dabonetn/Apple2Card-Dan-CR-Board-/PCB Front.jpg

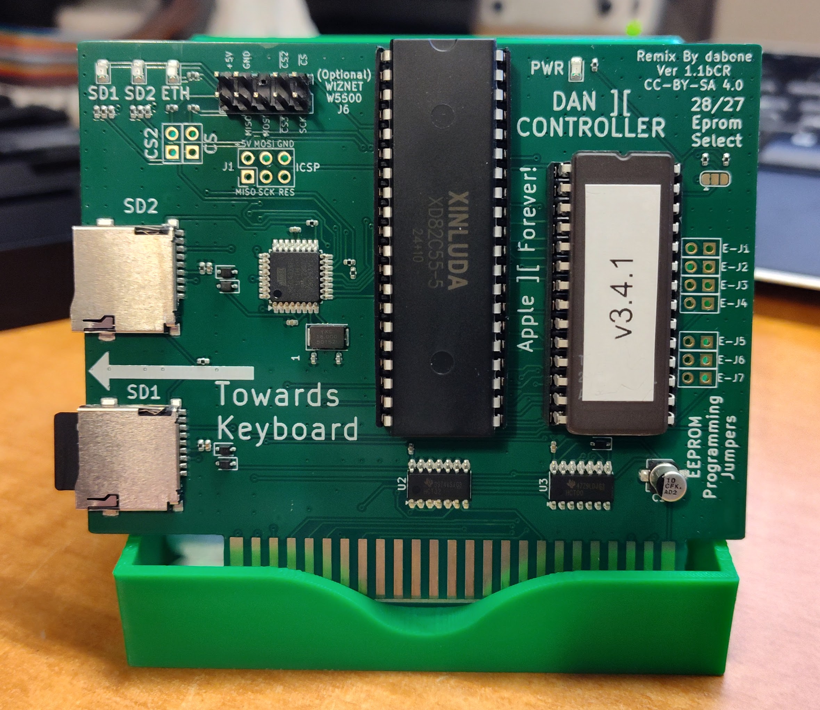
PCB Front.jpg
