dabonetn/Apple2Card-Dan-CR-Board-/Schematics.jpg

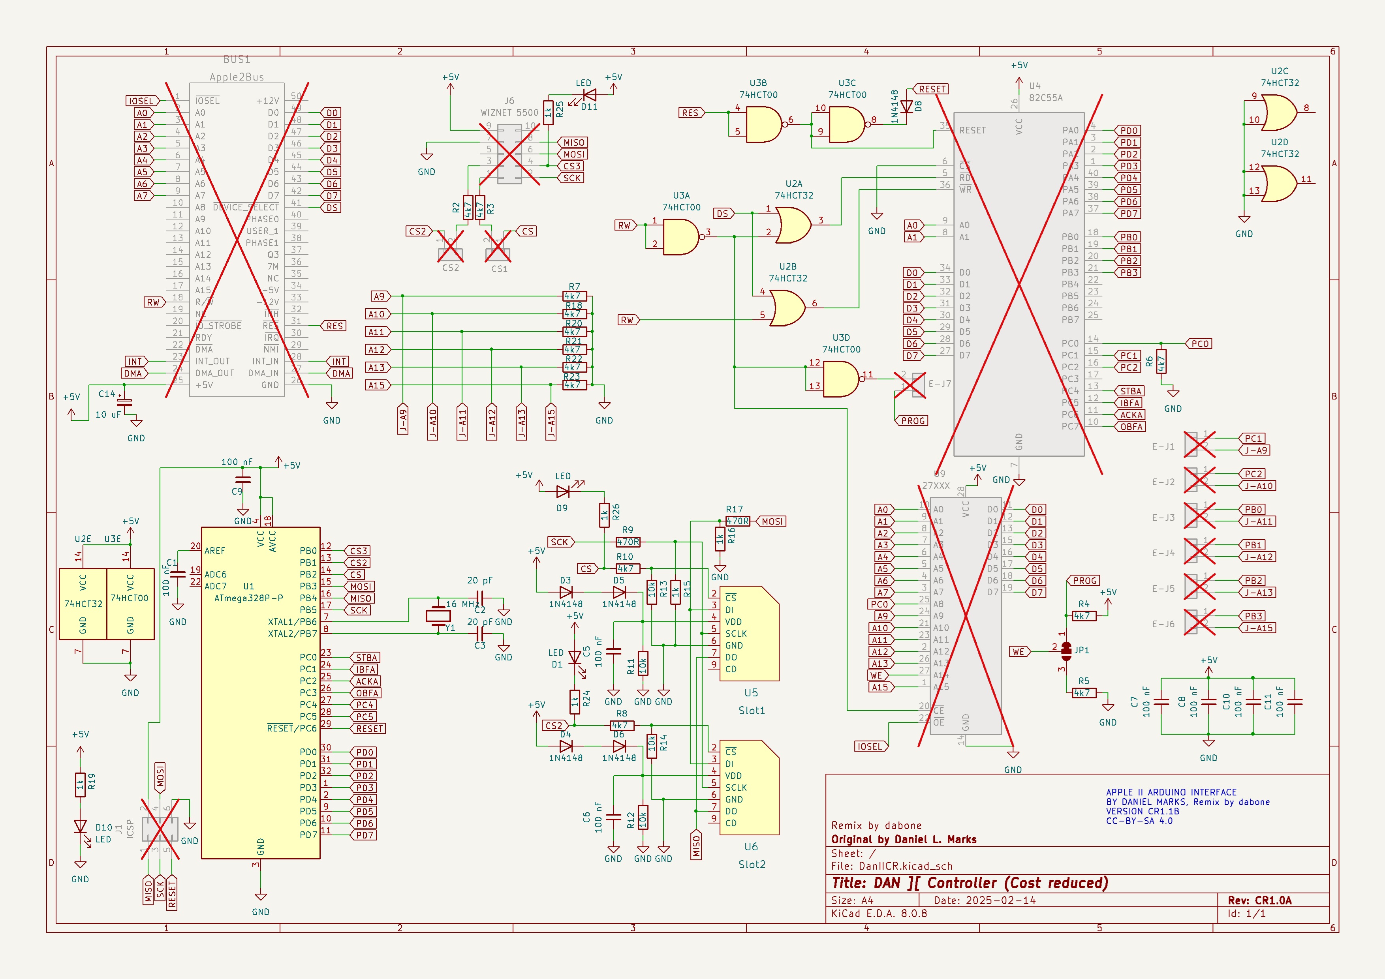
Schematics.jpg
