dabonetn/Apple2Card-Dan-CR-Board-/CAD/Apple IIe Ethernet Bracket Remix -M3.stl

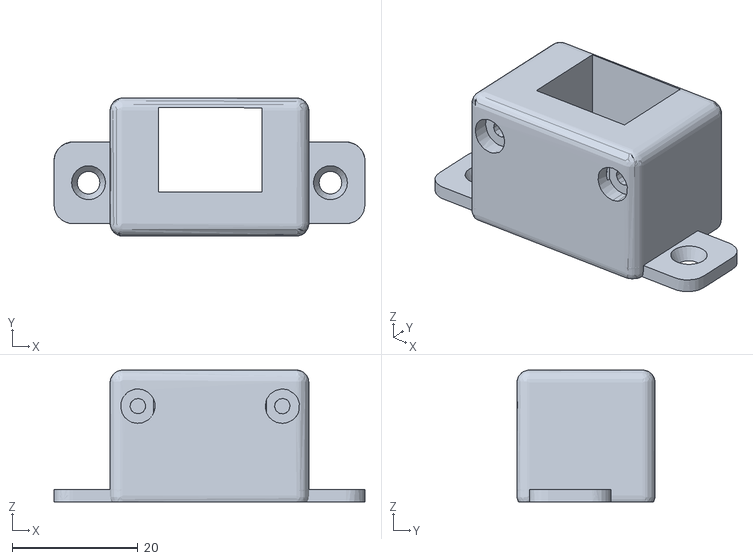
[picture p13: CAD file, 2025-04-05]
CAD/Apple IIe Ethernet Bracket Remix -M3.stl
49.5 x 22.0 x 21.0
