dabonetn/Apple2Card-Dan-CR-Board-/OriginalFiles/CAD/EthernetCover.FCStd

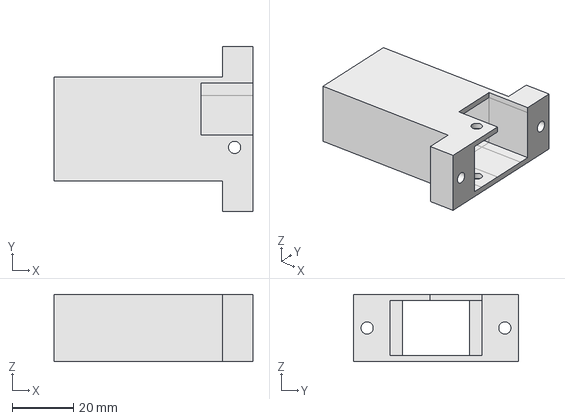
[picture p14: CAD file, 2025-02-25]
OriginalFiles/CAD/EthernetCover.FCStd
65.0 x 54.0 x 22.0 mm
