dabonetn/Apple2Card-Dan-CR-Board-/CAD/Apple IIe Ethernet Bracket Remix -M3 -Internal Bracket.stl

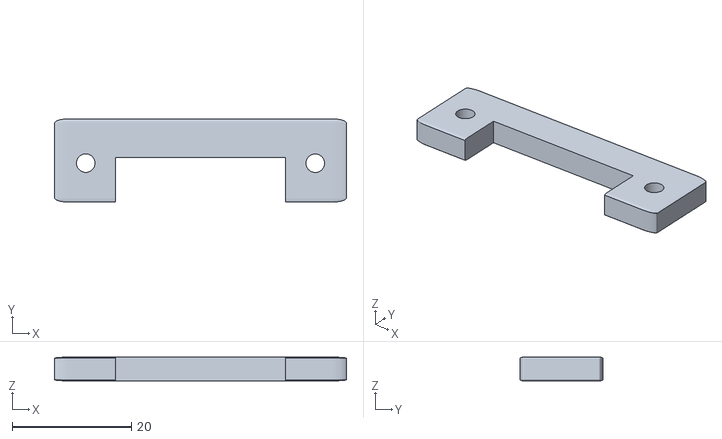
[picture p15: CAD file, 2025-04-05]
CAD/Apple IIe Ethernet Bracket Remix -M3 -Internal Bracket.stl
49.0 x 14.0 x 4.00
