dabonetn/Apple2Card-Dan-CR-Board-/OriginalFiles/CAD/Apple_IIe_EthernetMount_DB19.stl

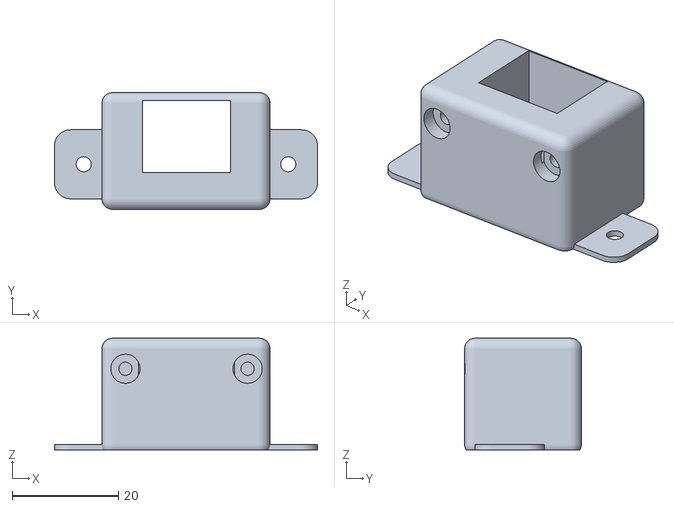
[picture p16: CAD file, 2023-09-25]
OriginalFiles/CAD/Apple_IIe_EthernetMount_DB19.stl
49.5 x 22.0 x 21.0
