dabonetn/Apple2Card-Dan-CR-Board-/OriginalFiles/CAD/AppleIII_Wiznet_Slot_Bracket.stl

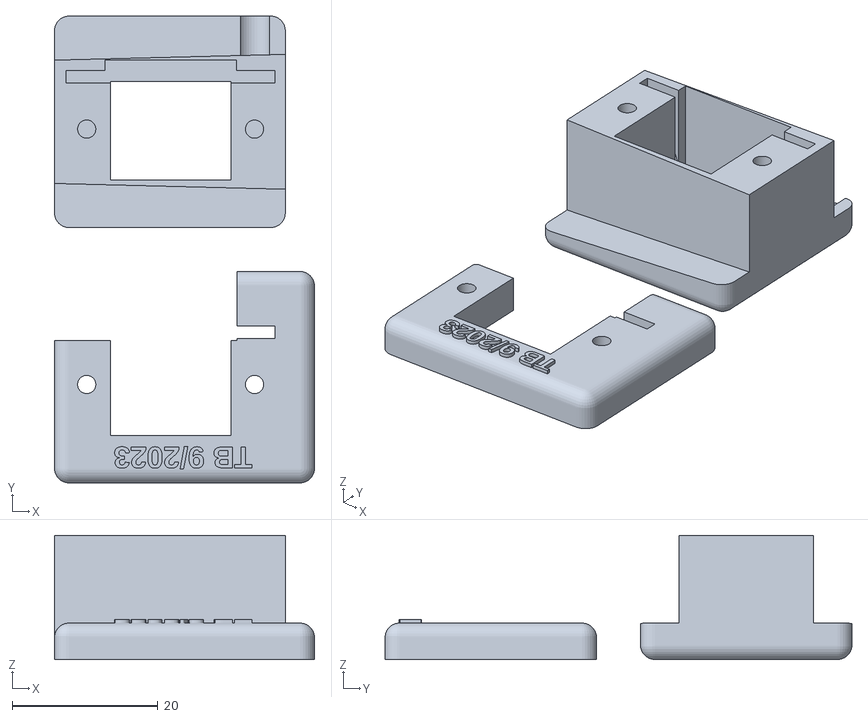
[picture p17: CAD file, 2023-09-20]
OriginalFiles/CAD/AppleIII_Wiznet_Slot_Bracket.stl
35.7 x 64.0 x 17.0
