dabonetn/Apple2Card-Dan-CR-Board-/(list of files, cad)

Other CAD files:
OriginalFiles/CAD/EthernetCover-EthernetMount.stl
