dabonetn/Apple2Card-Dan-CR-Board-/OriginalFiles/Apple2Card/Apple2Card-schematic.pdf

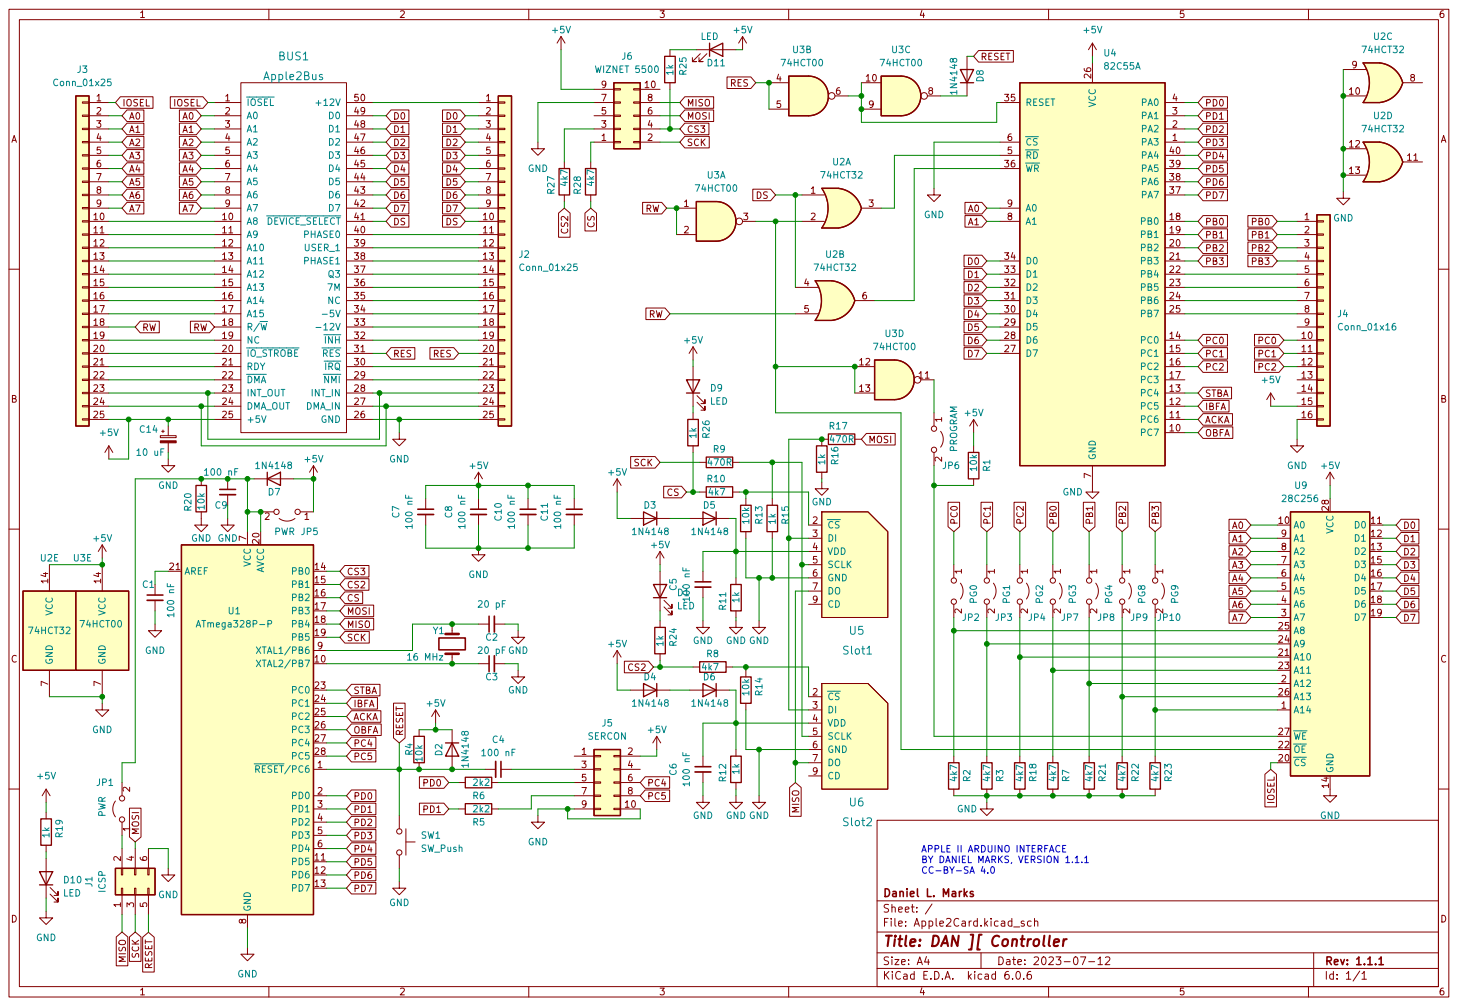
[picture p18: page 1]

13 | 13
14 | 14

APPLE II ARDUINO INTERFACE
BY DANIEL MARKS, VERSION 1.1.1 CC-BY-SA 4.0

File: Apple2Card.kicad_sch Sheet: / Daniel L. Marks

Id: 1/1 Title: DAN ][ Controller
