dabonetn/Apple2Card-Dan-CR-Board-/OriginalFiles/Apple2Card_x44/Apple2Card-schematic.pdf

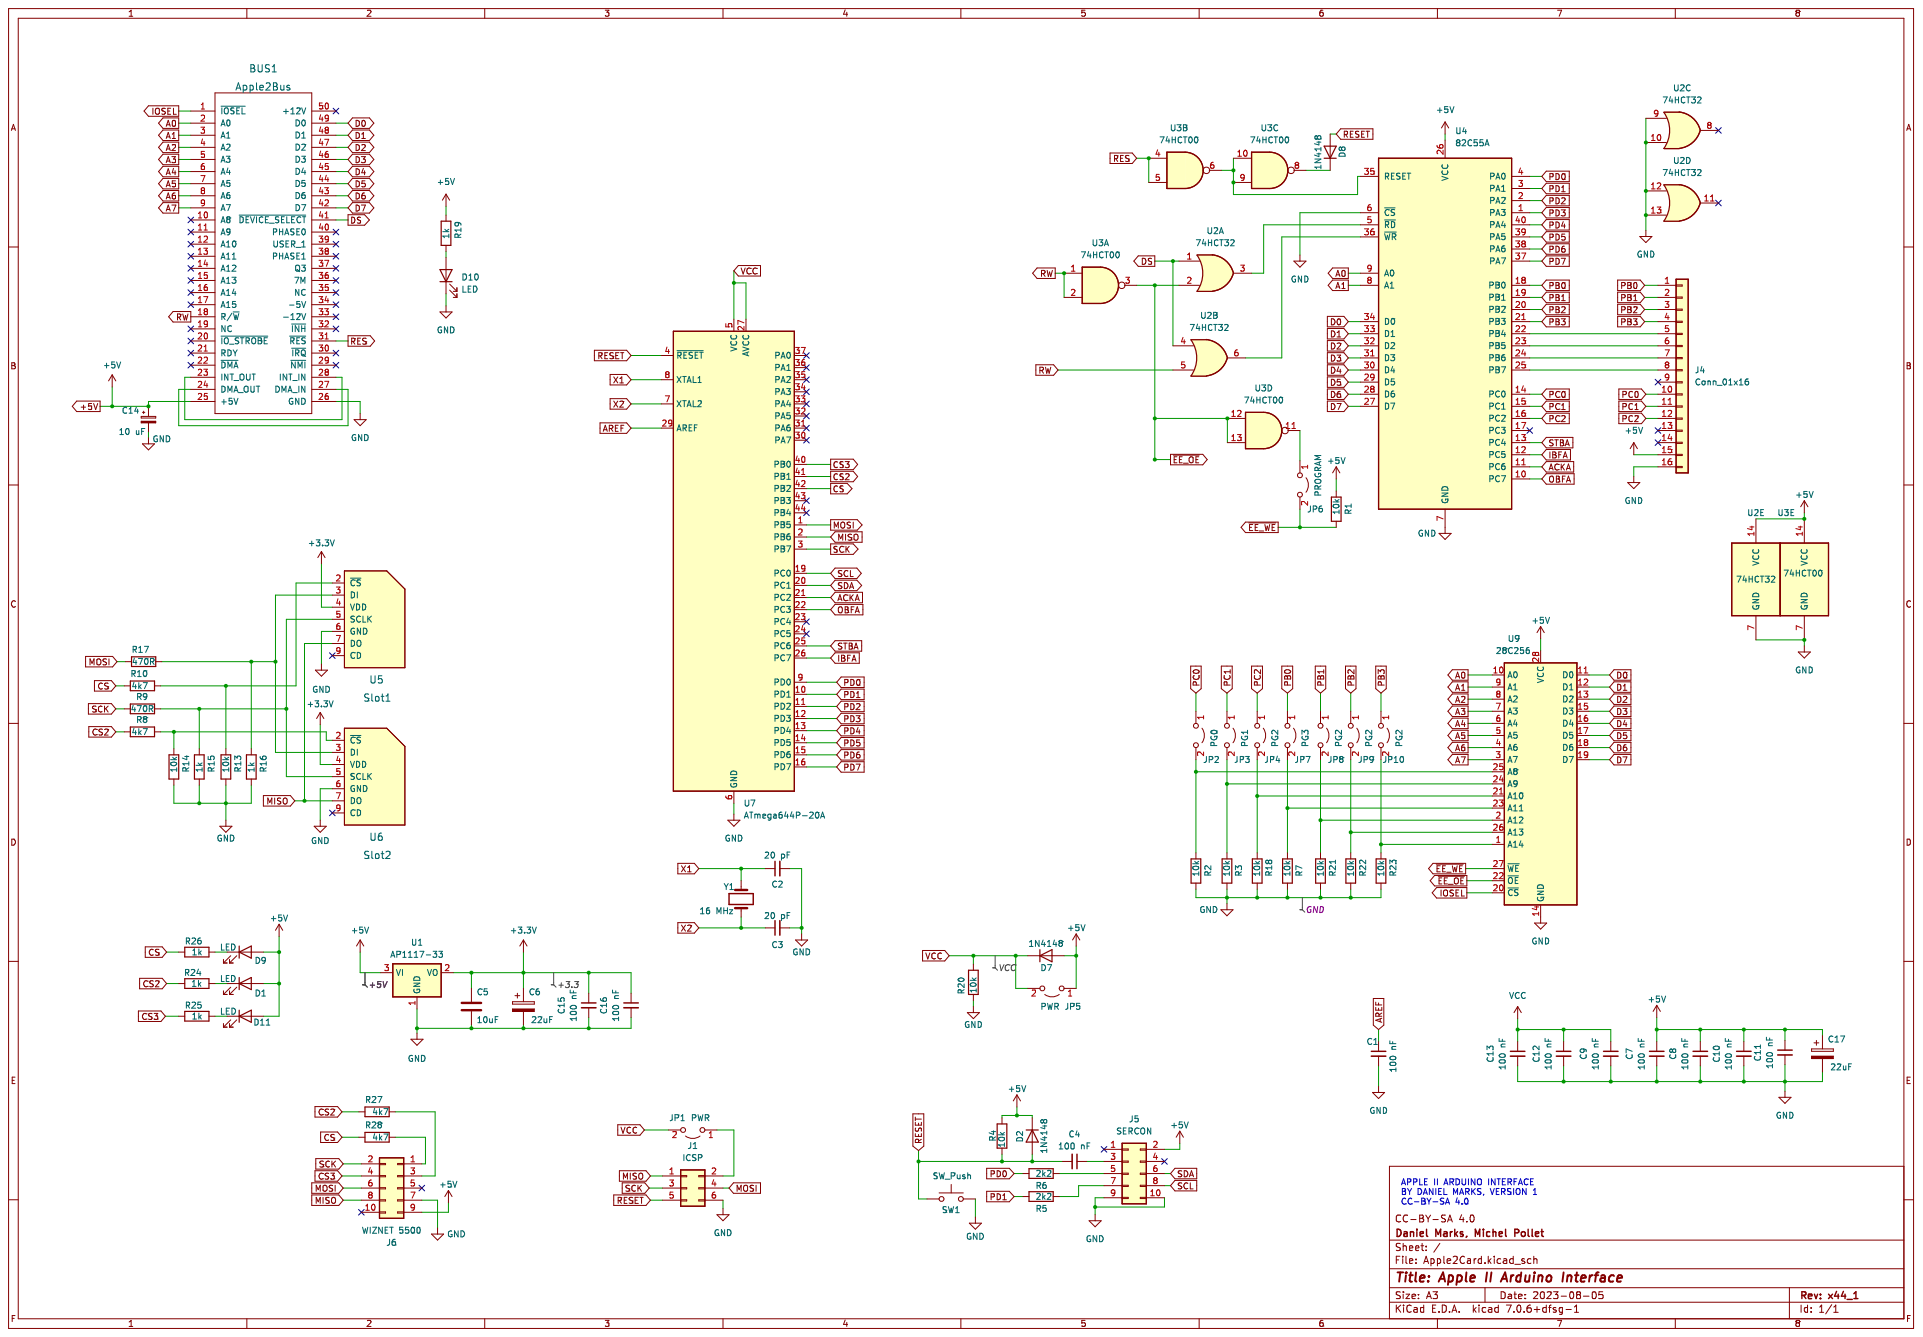
[picture p19: page 1]
