dabonetn/Apple2Card-Dan-CR-Board-/OriginalFiles/Apple2Card_x44/Apple2Card.kicad_pcb

## KiCad design OriginalFiles/Apple2Card_x44/Apple2Card.kicad_pcb (2023-08-09)

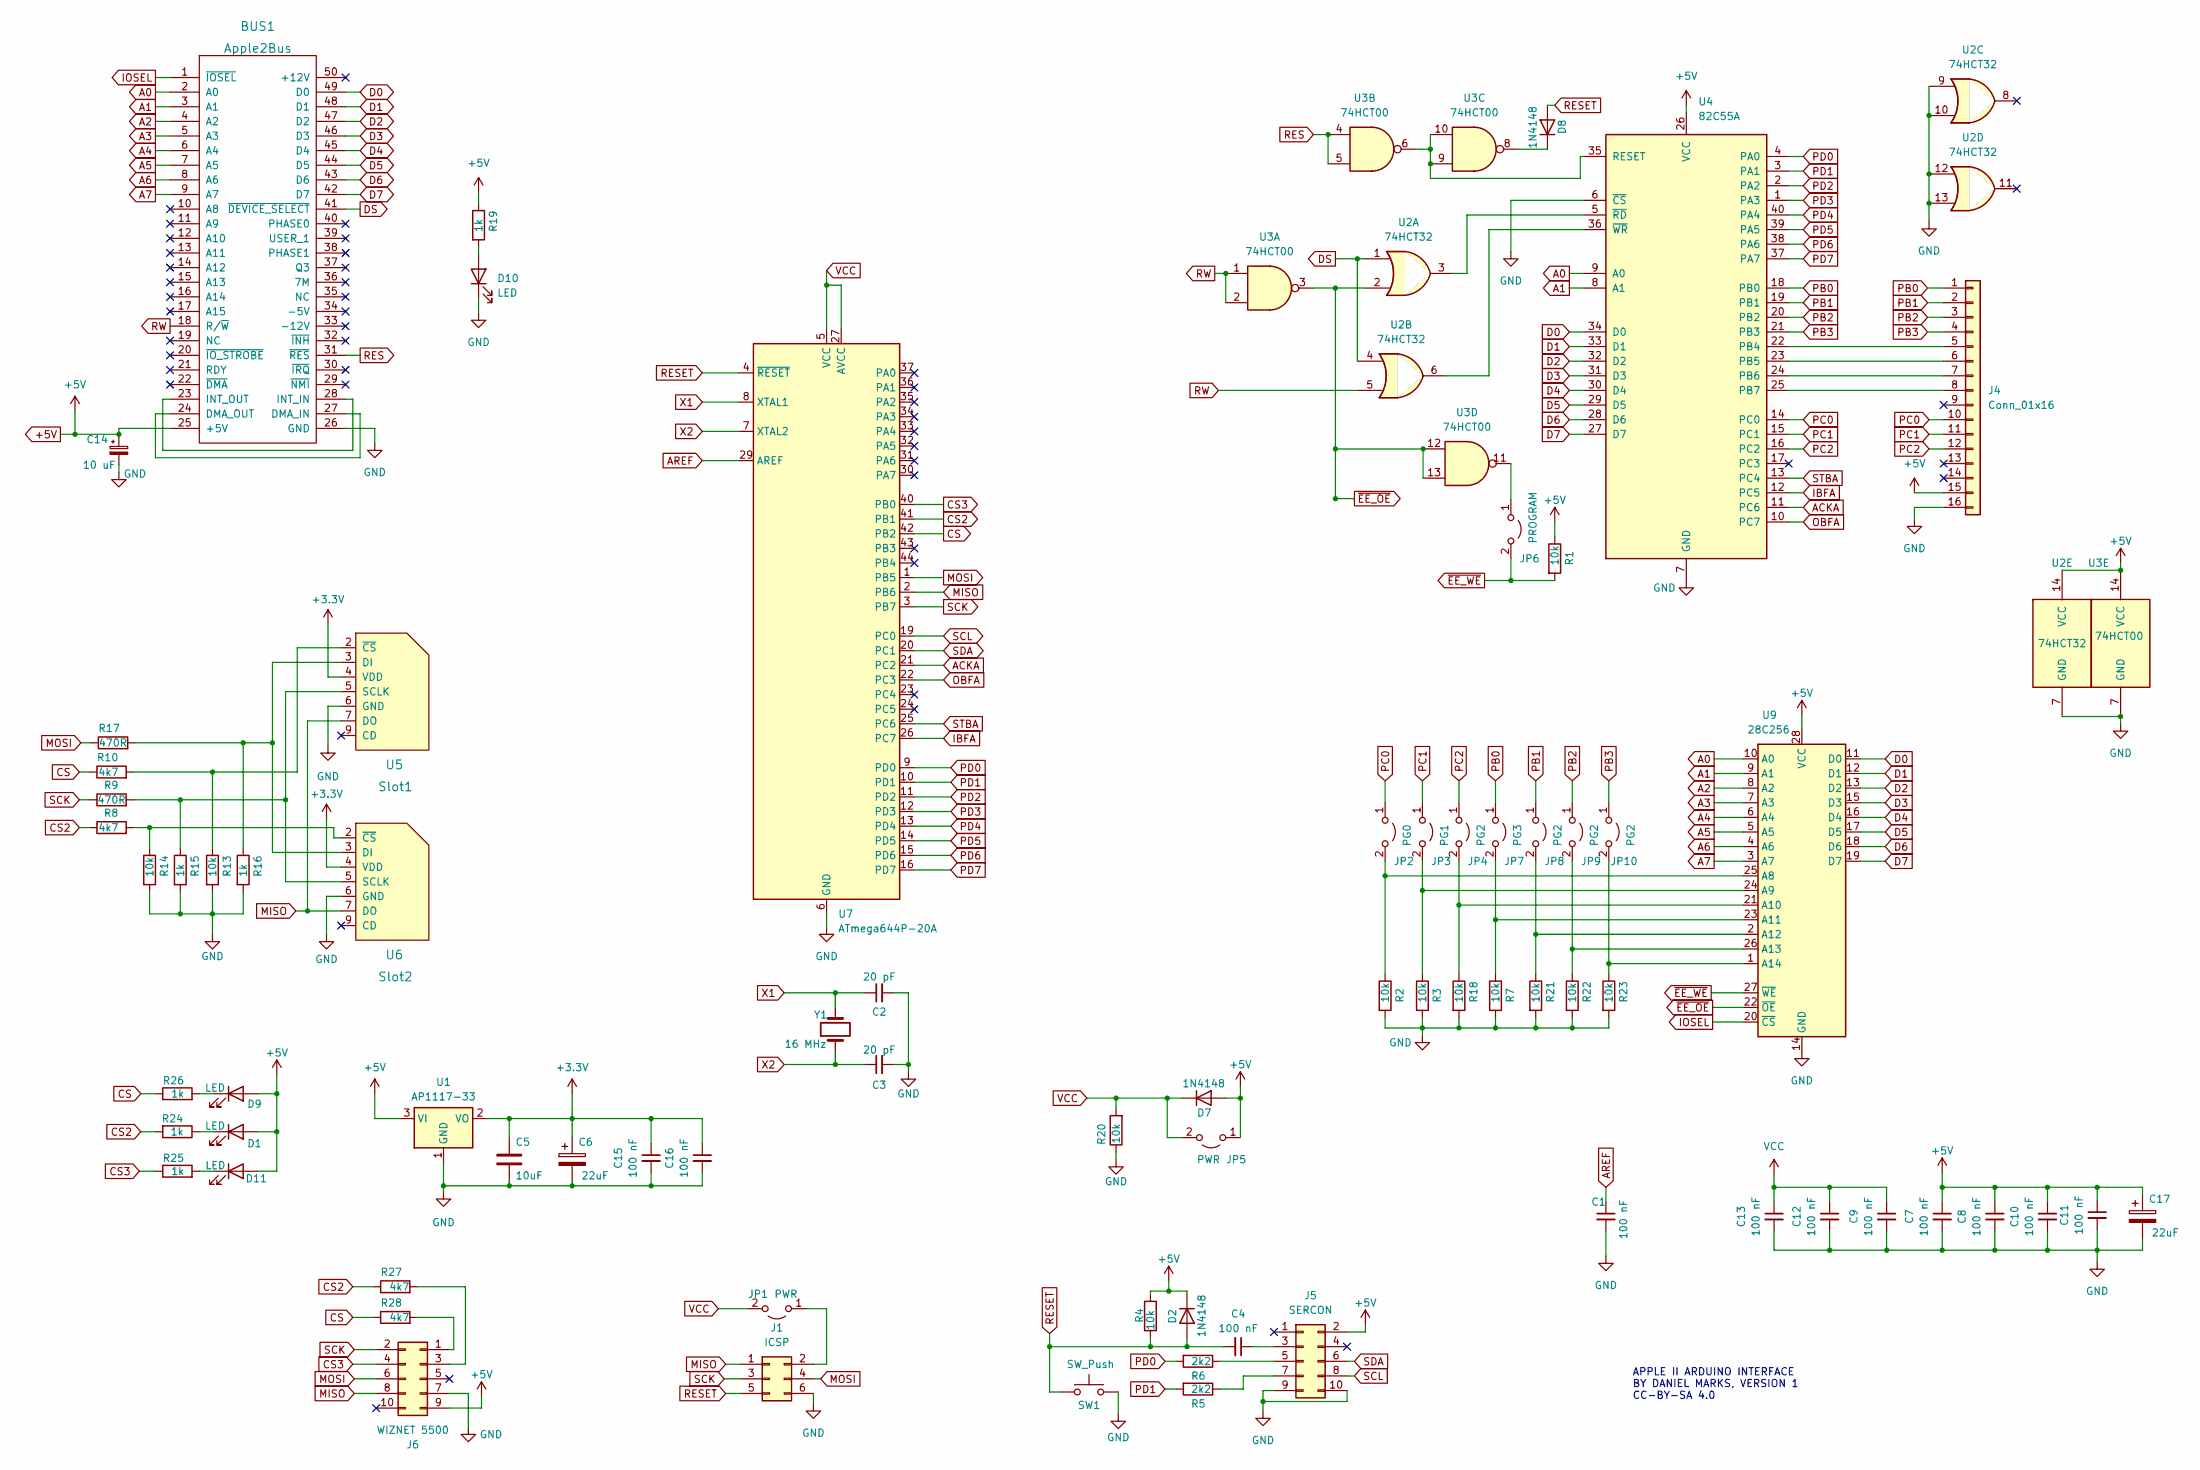
[picture p20: schematic Apple2Card.kicad_sch, Apple II Arduino Interface]

Parts:
BUS1: Apple2Bus; Apple2Slot
C1, C4, C7, C8, C9, C10, C11, C12, C13, C15, C16: 100 nF; C_0603_1608Metric_Pad1.08x0.95mm_HandSolder; LCSC C14663
C2, C3: 20 pF; C_0603_1608Metric_Pad1.08x0.95mm_HandSolder; LCSC C1620
C5: 10uF; C_0805_2012Metric_Pad1.18x1.45mm_HandSolder; LCSC C28323
C6, C17: 22uF; CP_EIA-6032-20_AVX-F_Pad2.25x2.35mm_HandSolder; LCSC C130377
C14: 10 uF; C_0805_2012Metric_Pad1.18x1.45mm_HandSolder; LCSC C1779
D1, D9, D11: LED; LED_0805_2012Metric_Pad1.15x1.40mm_HandSolder; LCSC C84256
D2, D7, D8: 1N4148; D_SOD-323_HandSoldering; LCSC C2128
D10: LED; LED_0805_2012Metric_Pad1.15x1.40mm_HandSolder; LCSC C434435
J1: ICSP; PinHeader_2x03_P2.54mm_Vertical; LCSC C492441
J4: Conn_01x16; PinHeader_1x16_P2.54mm_Vertical
J5: SERCON; PinHeader_2x05_P2.54mm_Vertical; LCSC C429962
J6: WIZNET 5500; PinHeader_2x05_P2.54mm_Vertical; LCSC C429962
JP1, JP5: PWR; PinHeader_1x02_P2.54mm_Vertical; LCSC C234182
JP2: PG0; PinHeader_1x02_P2.54mm_Vertical; LCSC C234182
JP3: PG1; PinHeader_1x02_P2.54mm_Vertical; LCSC C234182
JP4, JP8, JP9, JP10: PG2; PinHeader_1x02_P2.54mm_Vertical; LCSC C234182
JP6: PROGRAM; PinHeader_1x02_P2.54mm_Vertical; LCSC C234182
JP7: PG3; PinHeader_1x02_P2.54mm_Vertical; LCSC C234182
R1, R2, R3, R4, R7, R13, R14, R18, R20, R21, R22, R23: 10k; R_0603_1608Metric_Pad0.98x0.95mm_HandSolder; LCSC C25804
R5, R6: 2k2; R_0603_1608Metric_Pad0.98x0.95mm_HandSolder; LCSC C114662
R8, R10, R27, R28: 4k7; R_0603_1608Metric_Pad0.98x0.95mm_HandSolder; LCSC C105428
R9, R17: 470R; R_0603_1608Metric_Pad0.98x0.95mm_HandSolder; LCSC C114669
R15, R16, R19, R24, R25, R26: 1k; R_0603_1608Metric_Pad0.98x0.95mm_HandSolder; LCSC C21190
SW1: SW_Push; SW_Push_1P1T_NO_6x6mm_H9.5mm; LCSC C221869
U1: AP1117-33; SOT-223-3_TabPin2; LCSC C347222
U2: 74HCT32; SOIC-14_3.9x8.7mm_P1.27mm; LCSC C6781
U3: 74HCT00; SOIC-14_3.9x8.7mm_P1.27mm; LCSC C6764
U4: 82C55A; DIP-40_W15.24mm_Socket; LCSC C707086
U5: Slot1; GCT-MEM2055-00-190-01-A; LCSC C5155564
U6: Slot2; GCT-MEM2055-00-190-01-A; LCSC C5155564
U7: ATmega644P-20A; TQFP-44_10x10mm_P0.8mm
U9: 28C256; DIP-28_W15.24mm_Socket; LCSC C2874016
Y1: 16 MHz; Crystal_SMD_3225-4Pin_3.2x2.5mm_HandSoldering; LCSC C13738

Connections:
+3.3V: C5.1, C6.1, C15.1, C16.1, U1.2 (VO), U5.4 (VDD), U6.4 (VDD)
+5V: BUS1.25 (+5V), C7.1, C8.1, C10.1, C11.1, C14.1, C17.1, D1.2 (A), D2.1 (K), D7.2 (A), D9.2 (A), D11.2 (A), J4.15, J5.2, J6.9, JP5.1 (A), R1.1, R4.1, R19.1, U1.3 (VI), U2.14 (VCC), U3.14 (VCC), U4.26 (VCC), U9.28 (VCC)
A0: BUS1.2 (A0), U4.9 (A0), U9.10 (A0)
A1: BUS1.3 (A1), U4.8 (A1), U9.9 (A1)
A2: BUS1.4 (A2), U9.8 (A2)
A3: BUS1.5 (A3), U9.7 (A3)
A4: BUS1.6 (A4), U9.6 (A4)
A5: BUS1.7 (A5), U9.5 (A5)
A6: BUS1.8 (A6), U9.4 (A6)
A7: BUS1.9 (A7), U9.3 (A7)
ACKA: U4.11 (PC6), U7.21 (PC2)
AREF: C1.1, U7.29 (AREF)
CS: R10.1, R26.1, R28.1, U7.42 (PB2)
CS2: R8.1, R24.2, R27.1, U7.41 (PB1)
CS3: J6.4, R25.1, U7.40 (PB0)
D0: BUS1.49 (D0), U4.34 (D0), U9.11 (D0)
D1: BUS1.48 (D1), U4.33 (D1), U9.12 (D1)
D2: BUS1.47 (D2), U4.32 (D2), U9.13 (D2)
D3: BUS1.46 (D3), U4.31 (D3), U9.15 (D3)
D4: BUS1.45 (D4), U4.30 (D4), U9.16 (D4)
D5: BUS1.44 (D5), U4.29 (D5), U9.17 (D5)
D6: BUS1.43 (D6), U4.28 (D6), U9.18 (D6)
D7: BUS1.42 (D7), U4.27 (D7), U9.19 (D7)
DS: BUS1.41 (~DEVICE_SELECT), U2.1, U2.4
GND: BUS1.26 (GND), C1.2, C2.2, C3.2, C5.2, C6.2, C7.2, C8.2, C9.2, C10.2, C11.2, C12.2, C13.2, C14.2, C15.2, C16.2, C17.2, D10.1 (K), J1.6, J4.16, J5.9, J5.10, J6.7, R2.2, R3.2, R7.2, R13.2, R14.2, R15.2, R16.2, R18.2, R20.1, R21.2, R22.2, R23.2, SW1.2, U1.1 (GND), U2.7 (GND), U2.9, U2.10, U2.12, U2.13, U3.7 (GND), U4.6 (~CS), U4.7 (GND), U5.6 (GND), U6.6 (GND), U7.6 (GND), U7.18 (GND), U7.28 (GND), U7.39 (GND), U9.14 (GND)
IBFA: U4.12 (PC5), U7.26 (PC7)
IOSEL: BUS1.1 (~IOSEL), U9.20 (~CS)
MISO: J1.1, J6.8, U5.7 (DO), U6.7 (DO), U7.2 (PB6)
MOSI: J1.4, J6.6, R17.1, U7.1 (PB5)
unnamed: BUS1.24 (DMA_OUT), BUS1.27 (DMA_IN)
unnamed: BUS1.23 (INT_OUT), BUS1.28 (INT_IN)
unnamed: D1.1 (K), R24.1
unnamed: D8.1 (K), U3.8
unnamed: D9.1 (K), R26.2
unnamed: D10.2 (A), R19.2
unnamed: D11.1 (K), R25.2
unnamed: J1.2, JP1.1 (A)
unnamed: J4.5, U4.22 (PB4)
unnamed: J4.6, U4.23 (PB5)
unnamed: J4.7, U4.24 (PB6)
unnamed: J4.8, U4.25 (PB7)
unnamed: C4.1, J5.3
unnamed: J5.5, R6.1
unnamed: J5.7, R5.1
unnamed: J6.1, R28.2
unnamed: J6.3, R27.2
unnamed: JP2.2 (B), R2.1, U9.25 (A8)
unnamed: JP3.2 (B), R3.1, U9.24 (A9)
unnamed: JP4.2 (B), R18.1, U9.21 (A10)
unnamed: JP6.1 (A), U3.11
unnamed: JP7.2 (B), R7.1, U9.23 (A11)
unnamed: JP8.2 (B), R21.1, U9.2 (A12)
unnamed: JP9.2 (B), R22.1, U9.26 (A13)
unnamed: JP10.2 (B), R23.1, U9.1 (A14)
unnamed: U3.6, U3.9, U3.10, U4.35 (RESET)
unnamed: U2.3, U4.5 (~RD)
unnamed: U2.6, U4.36 (~WR)
unnamed: R16.1, R17.2, U5.3 (DI), U6.3 (DI)
unnamed: R9.2, R15.1, U5.5 (SCLK), U6.5 (SCLK)
unnamed: R10.2, R13.1, U5.2 (~CS)
unnamed: R8.2, R14.1, U6.2 (~CS)
OBFA: U4.10 (PC7), U7.22 (PC3)
PB0: J4.1, JP7.1 (A), U4.18 (PB0)
PB1: J4.2, JP8.1 (A), U4.19 (PB1)
PB2: J4.3, JP9.1 (A), U4.20 (PB2)
PB3: J4.4, JP10.1 (A), U4.21 (PB3)
PC0: J4.10, JP2.1 (A), U4.14 (PC0)
PC1: J4.11, JP3.1 (A), U4.15 (PC1)
PC2: J4.12, JP4.1 (A), U4.16 (PC2)
PD0: R6.2, U4.4 (PA0), U7.9 (PD0)
PD1: R5.2, U4.3 (PA1), U7.10 (PD1)
PD2: U4.2 (PA2), U7.11 (PD2)
PD3: U4.1 (PA3), U7.12 (PD3)
PD4: U4.40 (PA4), U7.13 (PD4)
PD5: U4.39 (PA5), U7.14 (PD5)
PD6: U4.38 (PA6), U7.15 (PD6)
PD7: U4.37 (PA7), U7.16 (PD7)
RES: BUS1.31 (~RES), U3.4, U3.5
RESET: C4.2, D2.2 (A), D8.2 (A), J1.5, R4.2, SW1.1, U7.4 (~RESET)
RW: BUS1.18 (R/~W), U2.5, U3.1, U3.2
SCK: J1.3, J6.2, R9.1, U7.3 (PB7)
SCL: J5.8, U7.19 (PC0)
SDA: J5.6, U7.20 (PC1)
STBA: U4.13 (PC4), U7.25 (PC6)
VCC: C9.1, C12.1, C13.1, D7.1 (K), JP1.2 (B), JP5.2 (B), R20.2, U7.5 (VCC), U7.17 (VCC), U7.27 (AVCC), U7.38 (VCC)
X1: C2.1, U7.8 (XTAL1), Y1.2
X2: C3.1, U7.7 (XTAL2), Y1.1
~EE_OE: U2.2, U3.3, U3.12, U3.13, U9.22 (~OE)
~EE_WE: JP6.2 (B), R1.2, U9.27 (~WE)

Notes on the sheet:
APPLE II ARDUINO INTERFACE BY DANIEL MARKS, VERSION 1 CC-BY-SA 4.0

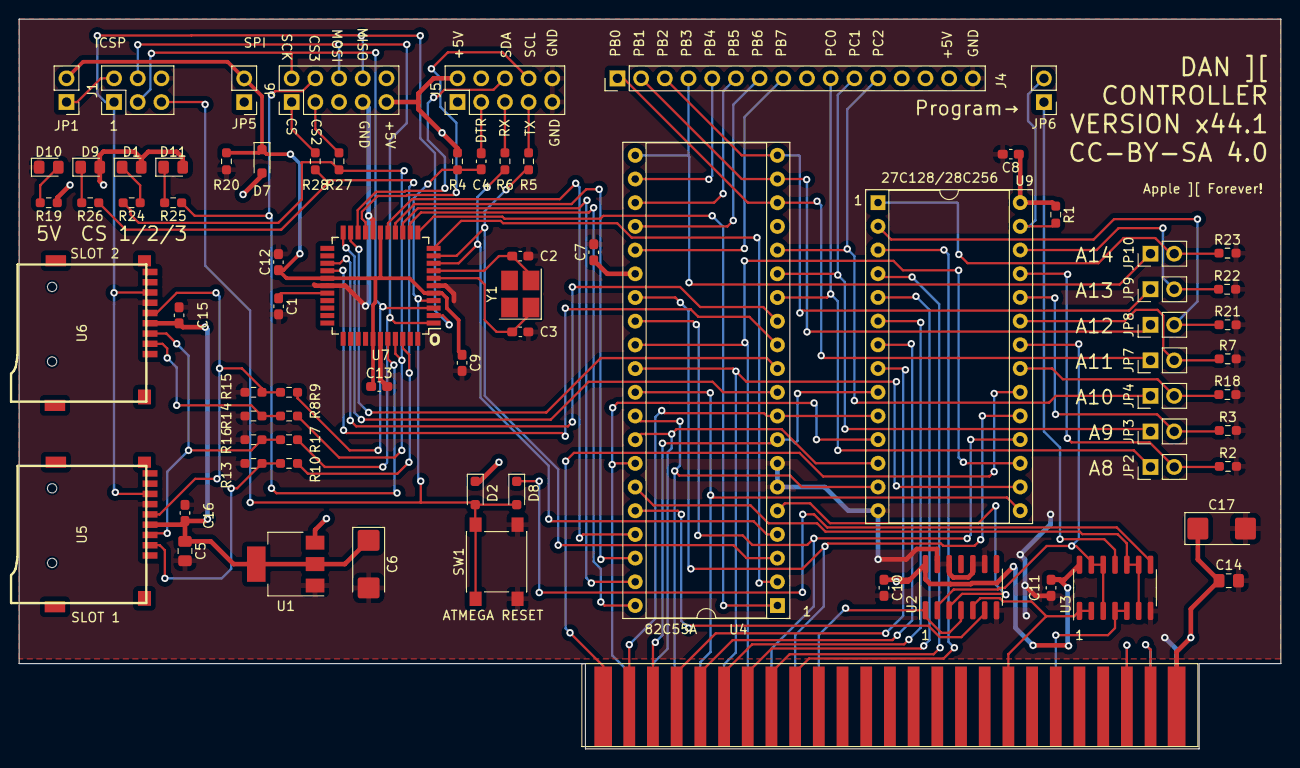
[picture p21: board Apple2Card.kicad_pcb from above]

Board: 2 copper layers, 135.3 x 78.2 mm, 75 parts (0 on the bottom side), 89 nets.
