dabonetn/Apple2Card-Dan-CR-Board-/Kicad/DanIICR.kicad_sch

## KiCad design Kicad/DanIICR.kicad_sch (2025-04-05)

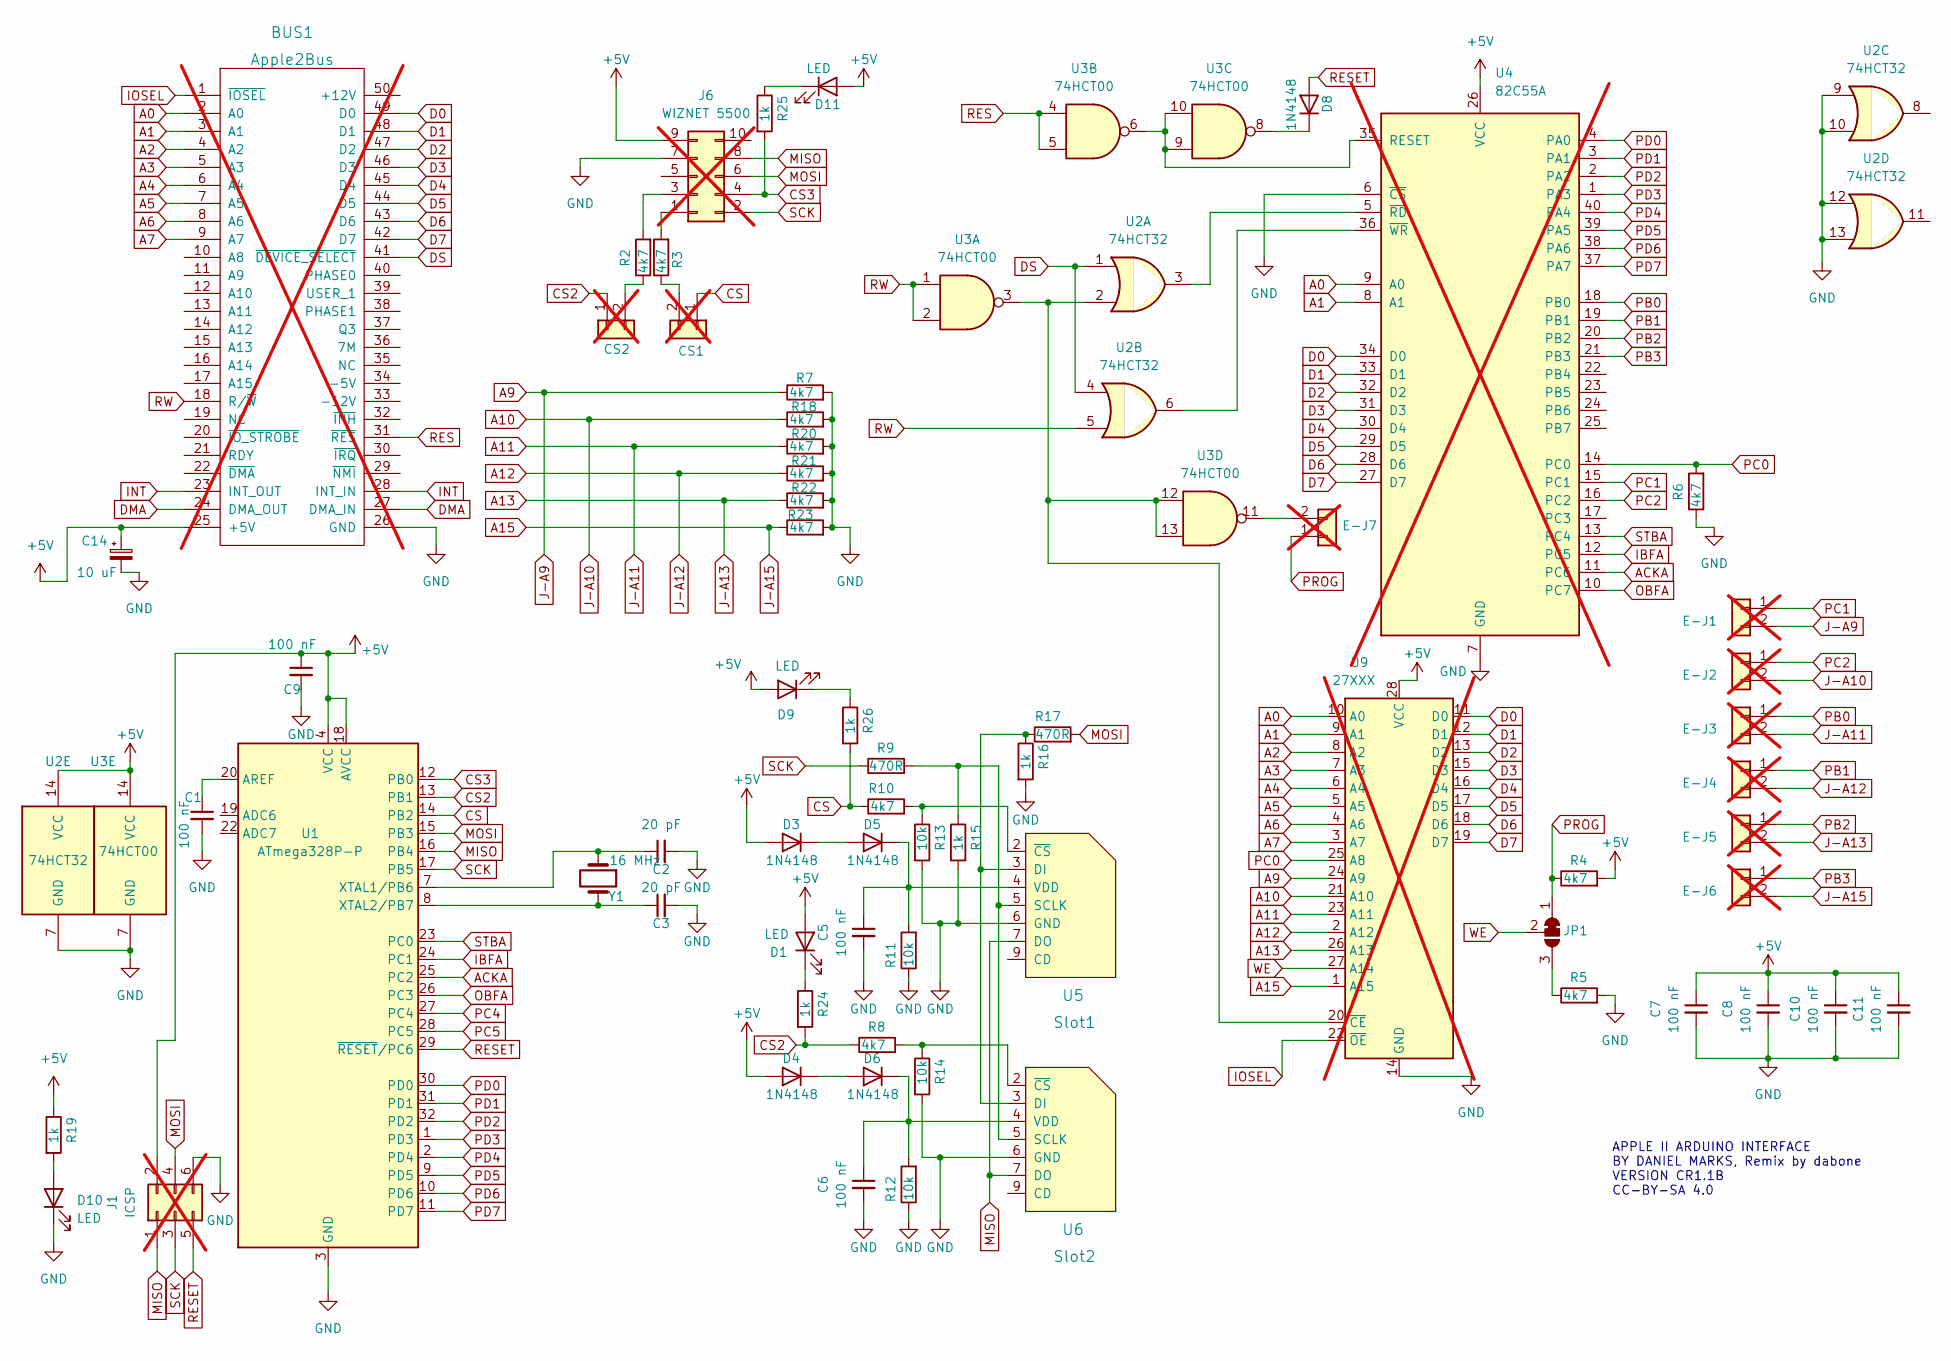
[picture p22: schematic DanIICR.kicad_sch]

Parts:
BUS1: Apple2Bus; Apple2Slot; not fitted
C1, C5, C6, C7, C8, C9, C10, C11: 100 nF; C_0402_1005Metric
C2, C3: 20 pF; C_0402_1005Metric
C14: 10 uF; CP_Elec_4x5.7
CS1, CS2: Jumper; PinHeader_1x02_P2.54mm_Vertical; not fitted
D1, D9, D10, D11: LED; LED_0805_2012Metric
D3, D4, D5, D6, D8: 1N4148; D_SOD-323
E-J1, E-J2, E-J3, E-J4, E-J5, E-J6, E-J7: Jumper; PinHeader_1x02_P2.54mm_Vertical; not fitted
J1: ICSP; PinHeader_2x03_P2.54mm_Vertical; not fitted
J6: WIZNET 5500; PinHeader_2x05_P2.54mm_Vertical; not fitted
JP1: SolderJumper_3_Bridged12; SolderJumper-3_P1.3mm_Bridged2Bar12_RoundedPad1.0x1.5mm
R2, R3, R4, R5, R6, R7, R10, R18, R20, R21, R22, R23: 4k7; R_0402_1005Metric
R8: 4k7; R_0402_1005Metric; LCSC Part # C2906941
R9, R17: 470R; R_0402_1005Metric
R11, R12, R13, R14: 10k; R_0402_1005Metric
R15, R16, R19, R24, R25, R26: 1k; R_0402_1005Metric
U1: ATmega328P-P; TQFP-32_7x7mm_P0.8mm
U2: 74HCT32; SOIC-14_3.9x8.7mm_P1.27mm
U3: 74HCT00; SOIC-14_3.9x8.7mm_P1.27mm
U4: 82C55A; DIP-40_W15.24mm_Socket; not fitted
U5: Slot1; MicroSD_Card_TB; LCSC Part # C381084
U6: Slot2; MicroSD_Card_TB; LCSC Part # C381084
U9: 27XXX; DIP-28_W15.24mm; not fitted
Y1: 16 MHz; Crystal_SMD_5032-2Pin_5.0x3.2mm

Connections:
+5V: BUS1.25 (+5V), C7.1, C8.1, C9.1, C10.1, C11.1, C14.1, D1.2 (A), D3.2 (A), D4.2 (A), D9.2 (A), D11.2 (A), J1.2, J6.9, R4.2, R19.1, U1.4 (VCC), U1.6 (VCC), U1.18 (AVCC), U2.14 (VCC), U3.14 (VCC), U4.26 (VCC), U9.28 (VCC)
A0: BUS1.2 (A0), U4.9 (A0), U9.10 (A0)
A1: BUS1.3 (A1), U4.8 (A1), U9.9 (A1)
A2: BUS1.4 (A2), U9.8 (A2)
A3: BUS1.5 (A3), U9.7 (A3)
A4: BUS1.6 (A4), U9.6 (A4)
A5: BUS1.7 (A5), U9.5 (A5)
A6: BUS1.8 (A6), U9.4 (A6)
A7: BUS1.9 (A7), U9.3 (A7)
A9: E-J1.2, R7.1, U9.24 (A9)
A10: E-J2.2, R18.1, U9.21 (A10)
A11: E-J3.2, R20.1, U9.23 (A11)
A12: E-J4.2, R21.1, U9.2 (A12)
A13: E-J5.2, R22.1, U9.26 (A13)
A15: E-J6.2, R23.1, U9.1 (A15)
ACKA: U1.25 (PC2), U4.11 (PC6)
CS: CS1.1, R10.1, R26.2, U1.14 (PB2)
CS2: CS2.1, R8.1, R24.2, U1.13 (PB1)
CS3: J6.4, R25.2, U1.12 (PB0)
D0: BUS1.49 (D0), U4.34 (D0), U9.11 (D0)
D1: BUS1.48 (D1), U4.33 (D1), U9.12 (D1)
D2: BUS1.47 (D2), U4.32 (D2), U9.13 (D2)
D3: BUS1.46 (D3), U4.31 (D3), U9.15 (D3)
D4: BUS1.45 (D4), U4.30 (D4), U9.16 (D4)
D5: BUS1.44 (D5), U4.29 (D5), U9.17 (D5)
D6: BUS1.43 (D6), U4.28 (D6), U9.18 (D6)
D7: BUS1.42 (D7), U4.27 (D7), U9.19 (D7)
DMA: BUS1.24 (DMA_OUT), BUS1.27 (DMA_IN)
DS: BUS1.41 (~DEVICE_SELECT), U2.1, U2.4
GND: BUS1.26 (GND), C1.2, C2.2, C3.2, C5.2, C6.2, C7.2, C8.2, C9.2, C10.2, C11.2, C14.2, D10.1 (K), J1.6, J6.7, R5.2, R6.1, R7.2, R11.1, R12.1, R13.2, R14.2, R15.2, R16.2, R18.2, R20.2, R21.2, R22.2, R23.2, U1.3 (GND), U1.5 (GND), U1.21 (GND), U2.7 (GND), U2.9, U2.10, U2.12, U2.13, U3.7 (GND), U4.6 (~CS), U4.7 (GND), U5.6 (GND), U6.6 (GND), U9.14 (GND)
IBFA: U1.24 (PC1), U4.12 (PC5)
INT: BUS1.23 (INT_OUT), BUS1.28 (INT_IN)
IOSEL: BUS1.1 (~IOSEL), U9.22 (~OE)
MISO: J1.1, J6.8, U1.16 (PB4), U5.7 (DO), U6.7 (DO)
MOSI: J1.4, J6.6, R17.2, U1.15 (PB3)
unnamed: C1.1, U1.20 (AREF)
unnamed: C2.1, U1.7 (XTAL1/PB6), Y1.1
unnamed: C3.1, U1.8 (XTAL2/PB7), Y1.2
unnamed: C5.1, D5.1 (K), R11.2, U5.4 (VDD)
unnamed: C6.1, D6.1 (K), R12.2, U6.4 (VDD)
unnamed: CS1.2, R3.1
unnamed: CS2.2, R2.1
unnamed: D1.1 (K), R24.1
unnamed: D3.1 (K), D5.2 (A)
unnamed: D4.1 (K), D6.2 (A)
unnamed: D8.1 (K), U3.8
unnamed: D9.1 (K), R26.1
unnamed: D10.2 (A), R19.2
unnamed: D11.1 (K), R25.1
unnamed: E-J7.2, U3.11
unnamed: J6.1, R3.2
unnamed: J6.3, R2.2
unnamed: JP1.3 (B), R5.1
unnamed: R10.2, R13.1, U5.2 (~CS)
unnamed: R8.2, R14.1, U6.2 (~CS)
unnamed: R9.2, R15.1, U5.5 (SCLK), U6.5 (SCLK)
unnamed: R16.1, R17.1, U5.3 (DI), U6.3 (DI)
unnamed: U2.2, U3.3, U3.12, U3.13, U9.20 (~CE)
unnamed: U2.3, U4.5 (~RD)
unnamed: U2.6, U4.36 (~WR)
unnamed: U3.6, U3.9, U3.10, U4.35 (RESET)
OBFA: U1.26 (PC3), U4.10 (PC7)
PB0: E-J3.1, U4.18 (PB0)
PB1: E-J4.1, U4.19 (PB1)
PB2: E-J5.1, U4.20 (PB2)
PB3: E-J6.1, U4.21 (PB3)
PC0: R6.2, U4.14 (PC0), U9.25 (A8)
PC1: E-J1.1, U4.15 (PC1)
PC2: E-J2.1, U4.16 (PC2)
PC4: U1.27 (PC4)
PC5: U1.28 (PC5)
PD0: U1.30 (PD0), U4.4 (PA0)
PD1: U1.31 (PD1), U4.3 (PA1)
PD2: U1.32 (PD2), U4.2 (PA2)
PD3: U1.1 (PD3), U4.1 (PA3)
PD4: U1.2 (PD4), U4.40 (PA4)
PD5: U1.9 (PD5), U4.39 (PA5)
PD6: U1.10 (PD6), U4.38 (PA6)
PD7: U1.11 (PD7), U4.37 (PA7)
PROG: E-J7.1, JP1.1 (A), R4.1
RES: BUS1.31 (~RES), U3.4, U3.5
RESET: D8.2 (A), J1.5, U1.29 (~RESET/PC6)
RW: BUS1.18 (R/~W), U2.5, U3.1, U3.2
SCK: J1.3, J6.2, R9.1, U1.17 (PB5)
STBA: U1.23 (PC0), U4.13 (PC4)
WE: JP1.2 (C), U9.27 (A14)

Notes on the sheet:
APPLE II ARDUINO INTERFACE BY DANIEL MARKS, Remix by dabone VERSION CR1.1B CC-BY-SA 4.0
