dabonetn/Apple2Card-Dan-CR-Board-/OriginalFiles/Apple2Arduino/mmc_avr_spi.c

/*-----------------------------------------------------------------------*/
/* MMCv3/SDv1/SDv2 Controls via AVR SPI module                           */
/*-----------------------------------------------------------------------*/
/*
/  Copyright (C) 2016, ChaN, all right reserved.
/
/ * This software is a free software and there is NO WARRANTY.
/ * No restriction on use. You can use, modify and redistribute it for
/   any purpose as you like UNDER YOUR RESPONSIBILITY.
/ * Redistributions of source code must retain the above copyright notice.
/
/-------------------------------------------------------------------------*/

//#include <Arduino.h>

#include <avr/io.h>
#include <avr/interrupt.h>
#include "diskio_sdc.h"
#include "mmc_avr.h"
#include "pindefs.h"


/* Peripheral controls (Platform dependent) */
#define CS_LOW()		do { PORTB &= (slotno ?  ~_BV(CS2) : ~_BV(CS)); } while (0) /* Set MMC_CS = low */
#define	CS_HIGH()		do { PORTB |= CS_ALL; } while (0) /* Set MMC_CS = high */
#define MMC_CD			(1)	/* Test if card detected.   yes:true, no:false, default:true */
#define MMC_WP			(0)	/* Test if write protected. yes:true, no:false, default:false */
// set fixed SPI mode
#define MMC_SPI_MODE()	do { SPCR = _BV(SPE) | _BV(MSTR); } while(0)
#define	FCLK_SLOW()		do { SPCR |= (_BV(SPR0)|_BV(SPR1)); } while (0)	/* Set SPI clock for initialization (100-400kHz) */
#define	FCLK_FAST()		do { SPCR &= ~(_BV(SPR0)|_BV(SPR1)); } while (0)	/* Set SPI clock for read/write (20MHz max) */
#define PULLUP_OFF()    do { PORTB &= ~_BV(MISO); } while (0)
#define PULLUP_ON()     do { PORTB |= _BV(MISO); } while (0)


/*--------------------------------------------------------------------------

   Module Private Functions

---------------------------------------------------------------------------*/

/* Definitions for MMC/SDC command */
#define CMD0	(0)			/* GO_IDLE_STATE */
#define CMD1	(1)			/* SEND_OP_COND (MMC) */
#define	ACMD41	(0x80+41)	/* SEND_OP_COND (SDC) */
#define CMD8	(8)			/* SEND_IF_COND */
#define CMD9	(9)			/* SEND_CSD */
#define CMD10	(10)		/* SEND_CID */
#define CMD12	(12)		/* STOP_TRANSMISSION */
#define ACMD13	(0x80+13)	/* SD_STATUS (SDC) */
#define CMD16	(16)		/* SET_BLOCKLEN */
#define CMD17	(17)		/* READ_SINGLE_BLOCK */
#define CMD18	(18)		/* READ_MULTIPLE_BLOCK */
#define CMD23	(23)		/* SET_BLOCK_COUNT (MMC) */
#define	ACMD23	(0x80+23)	/* SET_WR_BLK_ERASE_COUNT (SDC) */
#define CMD24	(24)		/* WRITE_BLOCK */
#define CMD25	(25)		/* WRITE_MULTIPLE_BLOCK */
#define CMD32	(32)		/* ERASE_ER_BLK_START */
#define CMD33	(33)		/* ERASE_ER_BLK_END */
#define CMD38	(38)		/* ERASE */
#define	CMD48	(48)		/* READ_EXTR_SINGLE */
#define	CMD49	(49)		/* WRITE_EXTR_SINGLE */
#define CMD55	(55)		/* APP_CMD */
#define CMD58	(58)		/* READ_OCR */


static volatile DSTATUS Stat[2] = { STA_NOINIT, STA_NOINIT };	/* Disk status */
static BYTE CardType[2];			/* Card type flags (b0:MMC, b1:SDv1, b2:SDv2, b3:Block addressing) */

BYTE slotno = 0;
BYTE mmc_busy = 0; /* flag indicating when a MMC card is still busy with a write/program operation */

/*-----------------------------------------------------------------------*/
/* Power Control  (Platform dependent)                                   */
/*-----------------------------------------------------------------------*/
/* When the target system does not support socket power control, there   */
/* is nothing to do in these functions and chk_power always returns 1.   */

static
void power_on (void)
{
	cli();
	DISABLE_CS();
	MMC_SPI_MODE();
	SPSR = _BV(SPI2X);
	DDRB |= CS_ALL | _BV(MOSI) | _BV(SCK);
	DDRB &= ~_BV(MISO);
	PORTB |= CS_ALL | _BV(MOSI) | _BV(SCK);
	PULLUP_ON();
	sei();
}

static
void power_off (void)
{
#if 0
	cli();
	SPCR = 0;
	DDRB &= ~(CS_ALL | _BV(MOSI) | _BV(MISO) | _BV(SCK));
	sei();
#endif
}

/*-----------------------------------------------------------------------*/
/* Transmit/Receive data from/to MMC via SPI  (Platform dependent)       */
/*-----------------------------------------------------------------------*/

/* Exchange a byte */
static
BYTE xchg_spi (		/* Returns received data */
	BYTE dat		/* Data to be sent */
)
{
	SPDR = dat;
	loop_until_bit_is_set(SPSR, SPIF);
	return SPDR;
}

/* Send 0xFF */
static BYTE xchg_spi_FF()
{
    return xchg_spi(0xFF);
}

/* Receive a data block fast */
static
void rcvr_spi_multi (
	BYTE *p,	/* Data read buffer */
	UINT cnt	/* Size of data block */
)
{
	do {
		SPDR = 0xFF;
		loop_until_bit_is_set(SPSR, SPIF);
		*p++ = SPDR;
		SPDR = 0xFF;
		loop_until_bit_is_set(SPSR, SPIF);
		*p++ = SPDR;
	} while (cnt -= 2);
}


/* Send a data block fast */
static
void xmit_spi_multi (
	const BYTE *p,	/* Data block to be sent */
	UINT cnt		/* Size of data block */
)
{
	do {
		SPDR = *p++;
		loop_until_bit_is_set(SPSR, SPIF);
		SPDR = *p++;
		loop_until_bit_is_set(SPSR, SPIF);
	} while (cnt -= 2);
}



/*-----------------------------------------------------------------------*/
/* Wait for card ready                                                   */
/*-----------------------------------------------------------------------*/

static
int wait_ready (	/* 1:Ready, 0:Timeout */
	UINT wt			/* Timeout [ms] */
)
{
	BYTE d;
	uint16_t intime;

	intime = millis();
	do {
		d = xchg_spi_FF();
	} while (d != 0xFF && (((int16_t)(((uint16_t)millis())-intime)) < wt));

	mmc_busy = (d != 0xff); /* remember when MMC is busy */

	return (d == 0xFF) ? 1 : 0;
}



/*-----------------------------------------------------------------------*/
/* Deselect the card and release SPI bus                                 */
/*-----------------------------------------------------------------------*/

static
void deselect (void)
{
	CS_HIGH();		/* Set CS# high */
	xchg_spi_FF();	/* Dummy clock (force DO hi-z for multiple slave SPI) */
}



/*-----------------------------------------------------------------------*/
/* Select the card and wait for ready                                    */
/*-----------------------------------------------------------------------*/

static
int select (void)	/* 1:Successful, 0:Timeout */
{
	CS_LOW();		/* Set CS# low */
	xchg_spi_FF();	/* Dummy clock (force DO enabled) */

	if (wait_ready(500)) return 1;	/* Leading busy check: Wait for card ready */

	deselect();		/* Timeout */
	return 0;
}

/*-----------------------------------------------------------------------*/
/* Wait while a MMC card is still busy (and blocking the SPI bus)        */
/*-----------------------------------------------------------------------*/

void mmc_wait_busy_spi(void)
{
	/* see MMC SD Specification: a card keeps forcing DO low while it is busy
	 * programming. And it will only release DO when it is done AND gets an
	 * additional clock.
	 * This MMC driver has a busy check prior to any new command (wait_ready),
	 * so this is properly considered. But other SPI drivers (WIZnet/Ethernet)
	 * don't know about this.
	 * This method can be used to verify that the MMC has released the SPI bus
	 * prior to accessing other SPI device (using other SPI drivers, like WIZnet).
	 * We only do the busy check if we know that a write/program operation was
	 * pending (hence the MMC was known to be busy).
	 */
	if (mmc_busy)
	{
		if (select())  // select card, provide clocks, wait for ready, release card
			deselect();
	}
}

/*-----------------------------------------------------------------------*/
/* Receive a data packet from MMC                                        */
/*-----------------------------------------------------------------------*/

static
int rcvr_datablock (
	BYTE *buff,			/* Data buffer to store received data */
	UINT btr			/* Byte count (must be multiple of 4) */
)
{
	BYTE token;

    uint16_t intime = millis();

	do {							/* Wait for data packet in timeout of 200ms */
		token = xchg_spi_FF();
	} while ((token == 0xFF) && (((int16_t)(((uint16_t)millis())-intime)) < 200));
	if (token != 0xFE) return 0;	/* If not valid data token, return with error */

	rcvr_spi_multi(buff, btr);		/* Receive the data block into buffer */
	xchg_spi_FF();					/* Discard CRC */
	xchg_spi_FF();

	return 1;						/* Return with success */
}



/*-----------------------------------------------------------------------*/
/* Send a data packet to MMC                                             */
/*-----------------------------------------------------------------------*/

static
int xmit_datablock (
	const BYTE *buff,	/* 512 byte data block to be transmitted */
	BYTE token			/* Data/Stop token */
)
{
	BYTE resp;

	if (!wait_ready(500)) return 0;		/* Leading busy check: Wait for card ready to accept data block */

	xchg_spi(token);					/* Xmit data token */
	if (token == 0xFD) return 1;		/* Do not send data if token is StopTran */

	xmit_spi_multi(buff, 512);			/* Data */
	xchg_spi_FF(); xchg_spi_FF();		/* Dummy CRC */

	resp = xchg_spi_FF();				/* Receive data resp */

	mmc_busy = (xchg_spi_FF() != 0xff);	/* after each write: remember MMC busy state */

	return (resp & 0x1F) == 0x05 ? 1 : 0;	/* Data was accepted or not */

	/* Busy check is done at next transmission */
}

/*-----------------------------------------------------------------------*/
/* Send a command packet to MMC                                          */
/*-----------------------------------------------------------------------*/

static
BYTE send_cmd (		/* Returns R1 resp (bit7==1:Send failed) */
	BYTE cmd,		/* Command index */
	DWORD arg		/* Argument */
)
{
	BYTE n, res;

	if (cmd & 0x80) {	/* ACMD<n> is the command sequense of CMD55-CMD<n> */
		cmd &= 0x7F;
		res = send_cmd(CMD55, 0);
		if (res > 1) return res;
	}

	/* Select the card and wait for ready except to stop multiple block read */
	if (cmd != CMD12) {
		deselect();
		if (!select()) return 0xFF;
	}

	/* Send command packet */
	xchg_spi(0x40 | cmd);				/* Start + Command index */
	xchg_spi((BYTE)(arg >> 24));		/* Argument[31..24] */
	xchg_spi((BYTE)(arg >> 16));		/* Argument[23..16] */
	xchg_spi((BYTE)(arg >> 8));			/* Argument[15..8] */
	xchg_spi((BYTE)arg);				/* Argument[7..0] */
	n = 0x01;							/* Dummy CRC + Stop */
	if (cmd == CMD0) n = 0x95;			/* Valid CRC for CMD0(0) + Stop */
	if (cmd == CMD8) n = 0x87;			/* Valid CRC for CMD8(0x1AA) Stop */
	xchg_spi(n);

	/* Receive command response */
	if (cmd == CMD12) xchg_spi_FF();		/* Skip a stuff byte when stop reading */
	n = 10;								/* Wait for a valid response in timeout of 10 attempts */
	do
		res = xchg_spi_FF();
	while ((res & 0x80) && --n);

	return res;			/* Return with the response value */
}



/*--------------------------------------------------------------------------

   Public Functions

---------------------------------------------------------------------------*/


/*-----------------------------------------------------------------------*/
/* Initialize Disk Drive                                                 */
/*-----------------------------------------------------------------------*/

DSTATUS mmc_disk_initialize (void)
{
	BYTE n, cmd, ty, isidle, ocr[4];

	if ((Stat[slotno] & STA_NOINIT) == 0) return Stat[slotno];  /* Already initialized? */

#if 0 // power_off is not implemented anyway, so we neither need the voltage drain delay
	power_off();						/* Turn off the socket power to reset the card */
	delay(100);
#endif
	if (Stat[slotno] & STA_NODISK) return Stat[slotno];	/* No card in the socket? */

	power_on();							/* Turn on the socket power */
	FCLK_SLOW();
	for (n = 10; n; n--) xchg_spi_FF();	/* 80 dummy clocks */

	/* send CMD0="GO IDLE" command to reset the SD card. Since we haven't done a physical reset,
	 hence, we don't know its current state, we may need to repeat & briefly wait
	 until the card confirms to be idle. */
	n=5;
	do
	{
		isidle = send_cmd(CMD0, 0);	// send "GO IDLE" command to reset the card
	} while ((isidle==0)&&(--n));	// wait/retry if card responds with 0==not idle (yet)

	ty = 0;
	if (isidle == 1) {			/* Card is idle now. Now put the card in SPI mode. */
	    uint16_t intime = millis(), curtime;

		if (send_cmd(CMD8, 0x1AA) == 1) {	/* Is the card SDv2? */
			for (n = 0; n < 4; n++) ocr[n] = xchg_spi_FF();	/* Get trailing return value of R7 resp */

			if (ocr[2] == 0x01 && ocr[3] == 0xAA) {				/* The card can work at vdd range of 2.7-3.6V */
				while ((((int16_t)(((uint16_t)millis())-intime)) < 1000) && send_cmd(ACMD41, 1UL << 30));
 				/* Wait for leaving idle state (ACMD41 with HCS bit) */

				if ((((int16_t)(((uint16_t)millis())-intime)) < 1000) && send_cmd(CMD58, 0) == 0) {		/* Check CCS bit in the OCR */
					for (n = 0; n < 4; n++) ocr[n] = xchg_spi_FF();
					ty = (ocr[0] & 0x40) ? CT_SDC2 | CT_BLOCK : CT_SDC2;	/* Check if the card is SDv2 */
				}
			}
		} else {							/* SDv1 or MMCv3 */
			if (send_cmd(ACMD41, 0) <= 1) 	{
				ty = CT_SDC1; cmd = ACMD41;	/* SDv1 */
			} else {
				ty = CT_MMC3; cmd = CMD1;	/* MMCv3 */
			}
			while ((((int16_t)(((uint16_t)millis())-intime)) < 1000) && send_cmd(cmd, 0));			/* Wait for leaving idle state */
			if (!(((int16_t)(((uint16_t)millis())-intime)) < 1000) || send_cmd(CMD16, 512) != 0)	/* Set R/W block length to 512 */
				ty = 0;
		}
	}

	CardType[slotno] = ty;
	deselect();

	if (ty) {			/* Initialization succeded */
		Stat[slotno] &= ~STA_NOINIT;		/* Clear STA_NOINIT */
		FCLK_FAST();
	} else {			/* Initialization failed */
		power_off();
		Stat[slotno] |= STA_NOINIT; /* init failed, consider this card no longer initialized */
	}
    PULLUP_OFF();
	return Stat[slotno];
}



/*-----------------------------------------------------------------------*/
/* Get Disk Status                                                       */
/*-----------------------------------------------------------------------*/

DSTATUS mmc_disk_status (void)
{
	return Stat[slotno];
}

/*-----------------------------------------------------------------------*/
/* Read Sector(s)                                                        */
/*-----------------------------------------------------------------------*/

DRESULT mmc_disk_read (
	BYTE *buff,			/* Pointer to the data buffer to store read data */
	LBA_t sector,		/* Start sector number (LBA) */
	UINT count			/* Sector count (1..128) */
)
{
	BYTE cmd;
	DWORD sect = (DWORD)sector;

	if (!count) return RES_PARERR;
	if (Stat[slotno] & STA_NOINIT) return RES_NOTRDY;

	MMC_SPI_MODE(); // restore our preferred SPI setting

	if (!(CardType[slotno] & CT_BLOCK)) sect *= 512;	/* Convert to byte address if needed */

	cmd = count > 1 ? CMD18 : CMD17;			/*  READ_MULTIPLE_BLOCK : READ_SINGLE_BLOCK */
	if (send_cmd(cmd, sect) == 0) {
		do {
			if (!rcvr_datablock(buff, 512)) break;
			buff += 512;
		} while (--count);
		if (cmd == CMD18) send_cmd(CMD12, 0);	/* STOP_TRANSMISSION */
	}
	deselect();

	return count ? RES_ERROR : RES_OK;
}



/*-----------------------------------------------------------------------*/
/* Write Sector(s)                                                       */
/*-----------------------------------------------------------------------*/

DRESULT mmc_disk_write (
	const BYTE *buff,	/* Pointer to the data to be written */
	LBA_t sector,		/* Start sector number (LBA) */
	UINT count			/* Sector count (1..128) */
)
{
	DWORD sect = (DWORD)sector;

	if (!count) return RES_PARERR;
	if (Stat[slotno] & STA_NOINIT) return RES_NOTRDY;
	if (Stat[slotno] & STA_PROTECT) return RES_WRPRT;

	MMC_SPI_MODE(); // restore our preferred SPI setting

	if (!(CardType[slotno] & CT_BLOCK)) sect *= 512;	/* Convert to byte address if needed */

	if (count == 1) {	/* Single block write */
		if ((send_cmd(CMD24, sect) == 0)	/* WRITE_BLOCK */
			&& xmit_datablock(buff, 0xFE)) {
			count = 0;
		}
	}
	else {				/* Multiple block write */
		if (CardType[slotno] & CT_SDC) send_cmd(ACMD23, count);
		if (send_cmd(CMD25, sect) == 0) {	/* WRITE_MULTIPLE_BLOCK */
			do {
				if (!xmit_datablock(buff, 0xFC)) break;
				buff += 512;
			} while (--count);
			if (!xmit_datablock(0, 0xFD)) count = 1;	/* STOP_TRAN token */
		}
	}
	deselect();

	return count ? RES_ERROR : RES_OK;
}


/*-----------------------------------------------------------------------*/
/* Miscellaneous Functions                                               */
/*-----------------------------------------------------------------------*/

DRESULT mmc_disk_ioctl (
	BYTE cmd,		/* Control code */
	void *buff		/* Buffer to send/receive control data */
)
{
	DRESULT res;
	BYTE n, csd[16], *ptr = buff;
	DWORD csize;

	if (Stat[slotno] & STA_NOINIT) return RES_NOTRDY;

	MMC_SPI_MODE(); // restore our preferred SPI setting

	res = RES_ERROR;
	switch (cmd) {
	case CTRL_SYNC :		/* Make sure that no pending write process. Do not remove this or written sector might not left updated. */
		if (select()) res = RES_OK;
		deselect();
		break;

	case GET_SECTOR_COUNT :	/* Get number of sectors on the disk (DWORD) */
		if ((send_cmd(CMD9, 0) == 0) && rcvr_datablock(csd, 16)) {
			if ((csd[0] >> 6) == 1) {	/* SDC ver 2.00 */
				csize = csd[9] + ((WORD)csd[8] << 8) + ((DWORD)(csd[7] & 63) << 16) + 1;
				*(LBA_t*)buff = csize << 10;
			} else {					/* SDC ver 1.XX or MMC*/
				n = (csd[5] & 15) + ((csd[10] & 128) >> 7) + ((csd[9] & 3) << 1) + 2;
				csize = (csd[8] >> 6) + ((WORD)csd[7] << 2) + ((WORD)(csd[6] & 3) << 10) + 1;
				*(LBA_t*)buff = csize << (n - 9);
			}
			res = RES_OK;
		}
		deselect();
		break;

	case GET_BLOCK_SIZE :	/* Get erase block size in unit of sector (DWORD) */
		if (CardType[slotno] & CT_SDC2) {	/* SDv2? */
			if (send_cmd(ACMD13, 0) == 0) {	/* Read SD status */
				xchg_spi_FF();
				if (rcvr_datablock(csd, 16)) {				/* Read partial block */
					for (n = 64 - 16; n; n--) xchg_spi_FF();	/* Purge trailing data */
					*(DWORD*)buff = 16UL << (csd[10] >> 4);
					res = RES_OK;
				}
			}
		} else {					/* SDv1 or MMCv3 */
			if ((send_cmd(CMD9, 0) == 0) && rcvr_datablock(csd, 16)) {	/* Read CSD */
				if (CardType[slotno] & CT_SDC1) {	/* SDv1 */
					*(DWORD*)buff = (((csd[10] & 63) << 1) + ((WORD)(csd[11] & 128) >> 7) + 1) << ((csd[13] >> 6) - 1);
				} else {					/* MMCv3 */
					*(DWORD*)buff = ((WORD)((csd[10] & 124) >> 2) + 1) * (((csd[11] & 3) << 3) + ((csd[11] & 224) >> 5) + 1);
				}
				res = RES_OK;
			}
		}
		deselect();
		break;
	/* Following commands are never used by FatFs module */

	case MMC_GET_TYPE :		/* Get card type flags (1 byte) */
		*ptr = CardType[slotno];
		res = RES_OK;
		break;

	case MMC_GET_CSD :		/* Receive CSD as a data block (16 bytes) */
		if (send_cmd(CMD9, 0) == 0 && rcvr_datablock(ptr, 16)) {	/* READ_CSD */
			res = RES_OK;
		}
		deselect();
		break;

	case MMC_GET_CID :		/* Receive CID as a data block (16 bytes) */
		if (send_cmd(CMD10, 0) == 0 && rcvr_datablock(ptr, 16)) {	/* READ_CID */
			res = RES_OK;
		}
		deselect();
		break;

	case MMC_GET_OCR :		/* Receive OCR as an R3 resp (4 bytes) */
		if (send_cmd(CMD58, 0) == 0) {	/* READ_OCR */
			for (n = 4; n; n--) *ptr++ = xchg_spi_FF();
			res = RES_OK;
		}
		deselect();
		break;

	case MMC_GET_SDSTAT :	/* Receive SD status as a data block (64 bytes) */
		if (send_cmd(ACMD13, 0) == 0) {	/* SD_STATUS */
			xchg_spi_FF();
			if (rcvr_datablock(ptr, 64)) res = RES_OK;
		}
		deselect();
		break;

	case CTRL_POWER_OFF :	/* Power off */
 #if 0
		power_off();
		Stat[slotno] |= STA_NOINIT;
 #endif
		res = RES_OK;
		break;
	default:
		res = RES_PARERR;
	}

	return res;
}
