dabonetn/Apple2Card-Dan-CR-Board-/OriginalFiles/Apple2Arduino/bootpg_128vols_v7.h

/*******************************************************
 * GENERATED FILE
 *******************************************************/

const uint8_t bootblocks[] PROGMEM = {
  0xea, 0x8d, 0x0e, 0xc0, 0xa9, 0x20, 0x85, 0xf0, 0xa9, 0x60, 0x85, 0xf3,
  0xa5, 0x43, 0x4a, 0x4a, 0x4a, 0x4a, 0x29, 0x07, 0x09, 0xc0, 0x85, 0xf2,
  0xa0, 0x00, 0x84, 0xf1, 0x88, 0xb1, 0xf1, 0x85, 0xf1, 0xa9, 0x02, 0x85,
  0xf9, 0xe6, 0x46, 0xe6, 0x45, 0xe6, 0x45, 0x20, 0xf0, 0x00, 0x90, 0x06,
  0x20, 0xe2, 0xfb, 0x4c, 0xba, 0xfa, 0xc6, 0xf9, 0xd0, 0xeb, 0xa9, 0x00,
  0x85, 0xfc, 0x20, 0x93, 0xfe, 0x20, 0x89, 0xfe, 0x20, 0xc4, 0x0b, 0x20,
  0xb6, 0x08, 0x20, 0x01, 0x09, 0xa5, 0xf5, 0x85, 0x46, 0xa5, 0xf6, 0x85,
  0x47, 0x20, 0xab, 0x0b, 0x4c, 0xe6, 0x0c, 0x20, 0xd4, 0x08, 0x20, 0x6c,
  0x08, 0xa5, 0xf7, 0x85, 0x46, 0xa5, 0xf8, 0x85, 0x47, 0x4c, 0xaf, 0x0b,
  0xa9, 0x00, 0x85, 0xfb, 0xa9, 0x04, 0x85, 0x25, 0x20, 0x22, 0xfc, 0xa5,
  0xfb, 0x05, 0xfc, 0x85, 0x46, 0x09, 0x80, 0x85, 0x47, 0x20, 0xaf, 0x0b,
  0xa9, 0x00, 0x20, 0x42, 0x0a, 0xa9, 0xff, 0x85, 0x32, 0xa5, 0x43, 0x09,
  0x80, 0x85, 0x43, 0xa5, 0xfb, 0x09, 0x80, 0x85, 0xfb, 0xa9, 0x14, 0x20,
  0x42, 0x0a, 0xa9, 0xff, 0x85, 0x32, 0x4a, 0x25, 0x43, 0x85, 0x43, 0xe6,
  0x25, 0xe6, 0xfb, 0xa5, 0xfb, 0x29, 0x7f, 0x85, 0xfb, 0xc9, 0x10, 0x90,
  0xbf, 0x60, 0xa5, 0xf7, 0x85, 0xf5, 0xa5, 0xf8, 0x85, 0xf6, 0x60, 0xa0,
  0x00, 0x84, 0x24, 0xa0, 0x03, 0x84, 0x25, 0x20, 0x22, 0xfc, 0x20, 0x83,
  0x0b, 0xa0, 0x14, 0x84, 0x24, 0x4c, 0x7e, 0x0b, 0xa5, 0xfa, 0x48, 0xa9,
  0x15, 0x20, 0x62, 0x0b, 0x20, 0x8b, 0x0b, 0xa9, 0x14, 0x85, 0x24, 0x20,
  0x87, 0x0b, 0xa9, 0x01, 0x85, 0xfa, 0x20, 0x14, 0x0a, 0xc6, 0xfa, 0x10,
  0xf9, 0x68, 0x85, 0xfa, 0x60, 0x20, 0xc0, 0x0c, 0x20, 0xb6, 0x08, 0x68,
  0x68, 0x18, 0x4c, 0xe6, 0x0c, 0x20, 0x02, 0x0a, 0x20, 0xbf, 0x08, 0xa5,
  0xf5, 0x29, 0x70, 0x85, 0xfc, 0xa9, 0x00, 0x85, 0xfa, 0x20, 0x5b, 0x08,
  0x20, 0xda, 0x0b, 0xa9, 0x40, 0x20, 0x9e, 0x0a, 0x20, 0x14, 0x0a, 0x20,
  0x0c, 0xfd, 0x48, 0xa9, 0x01, 0x20, 0x9e, 0x0a, 0xa6, 0xfa, 0xb5, 0xf5,
  0x29, 0x8f, 0xa8, 0x68, 0xc9, 0x8d, 0xd0, 0x1f, 0xa9, 0x00, 0x20, 0x9e,
  0x0a, 0xa5, 0xfa, 0x49, 0x01, 0x85, 0xfa, 0xd0, 0x01, 0x60, 0xaa, 0xb5,
  0xf5, 0x29, 0x70, 0xc5, 0xfc, 0xf0, 0xcc, 0x85, 0xfc, 0x20, 0x5b, 0x08,
  0x4c, 0x17, 0x09, 0xc9, 0x9b, 0xf0, 0x9e, 0xc9, 0xa1, 0xd0, 0x05, 0xa9,
  0xff, 0x85, 0xf5, 0x60, 0xc9, 0xac, 0xf0, 0x04, 0xc9, 0x8b, 0xd0, 0x13,
  0x98, 0x0a, 0x08, 0x38, 0xe9, 0x02, 0x29, 0x1e, 0x28, 0x6a, 0x29, 0x8f,
  0x05, 0xfc, 0x95, 0xf5, 0x4c, 0x17, 0x09, 0xc9, 0xa0, 0xf0, 0x04, 0xc9,
  0x8a, 0xd0, 0x04, 0xc8, 0x98, 0xd0, 0xeb, 0xc9, 0x88, 0xd0, 0x1e, 0x98,
  0x49, 0x80, 0xa8, 0x05, 0xfc, 0x95, 0xf5, 0x10, 0xe3, 0xa9, 0xf0, 0x18,
  0x65, 0xfc, 0x29, 0x70, 0x85, 0xfc, 0x98, 0x48, 0x20, 0x5b, 0x08, 0xa6,
  0xfa, 0x68, 0x4c, 0x72, 0x09, 0xc9, 0x95, 0xd0, 0x0e, 0x98, 0x49, 0x80,
  0xa8, 0x05, 0xfc, 0x95, 0xf5, 0x30, 0xc1, 0xa9, 0x10, 0xd0, 0xdc, 0xc9,
  0xe1, 0x90, 0x03, 0x38, 0xe9, 0x20, 0xc9, 0xc1, 0x90, 0x09, 0xc9, 0xc7,
  0xb0, 0x05, 0x38, 0xe9, 0x07, 0xd0, 0x08, 0xc9, 0xb0, 0x90, 0x11, 0xc9,
  0xba, 0xb0, 0x0d, 0x29, 0x0f, 0x85, 0xf9, 0x98, 0x29, 0x80, 0x05, 0xf9,
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
};
