dabonetn/Apple2Card-Dan-CR-Board-/OriginalFiles/Apple2Arduino/APPLEIII_bootpg_stub.h

/*******************************************************
 * GENERATED FILE
 *******************************************************/

const uint8_t APPLE3boot[] PROGMEM = {
  0xea, 0xa2, 0xff, 0xe8, 0xbd, 0x14, 0xa0, 0xf0, 0x05, 0x20, 0x39, 0xfc,
  0xd0, 0xf5, 0x20, 0x4e, 0xfc, 0x4c, 0x01, 0xf9, 0xc4, 0xc1, 0xce, 0xc9,
  0xc9, 0xba, 0xa0, 0xce, 0xcf, 0xa0, 0xd6, 0xcf, 0xcc, 0xc1, 0xb3, 0xae,
  0xd0, 0xcf, 0xa1, 0x8d, 0x00
};
