dabonetn/Apple2Card-Dan-CR-Board-/(commit log)

2023-03-18 Improved boot menu. Added title and footer bar. Added ":" separators. Added option to keep existing card selection by pressing RETURN. Wipe screen before reboot. Swapped RETURN and SPACE keys in ROM 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
    [Apple2Arduino.ino]
2023-03-24 Improved SD-card compatibility (and performance)
    1. Compatibility fix for some SD cards
    After a power-down an SD card will always immediately respond to CMD0
    ("GO IDLE" command) with "1" ("in idle state"). However, since this controller
    hardware does not support physical power-down/reset, a card which was already
    initialized may also respond to CMD0 with "0" (=not idle (yet)), if it's still
    busy. In this case we need to briefly wait and poll the state again, until
    the SD card is indeed idle.
    This fixes a compatibility issue with some SDHC cards (e.g.
    "Intenso SDHC class 4" and likely other brands using the same SD core).
    2. Performance improvement
    The 100ms init delay after calling "power_o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
    [mmc_avr_spi.c]
2023-04-02 Improved bootpg build infrastructure Moved boot program to separate directory. Added option to build several boot programs. Readded original bootpg v2 by DL Marks as an option. Moved bootpg binary da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
2023-04-08 Minor fixes: return 0/1 not allowed in function returing void. This is picked up by newer compilers, e.g. with the Arduino minicore environment.
    [Apple2Arduino.ino]
2023-04-08 Minor command updates/extensions. Adapted do_get_volume command to return the EEPROM volume configuration, not the current (temporary) volume selection, which is what the config utility really wants 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
2023-04-08 Added new, improved variant boot program variant and improved boot ROM. - Boot program supports browsing the volumes (use arrow keys/space/+). - Bootloader instantly reacts to keypresses (skips boot 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
    [Apple2Arduino.ino, bootpg_cursor_v4.asm, bootpg_cursor_v4.h]
2023-04-20 Disable FatFs codepage support to save RAM. We don't care about filenames with non-ASCII characters. We only ever use known fixed and plain ASCII names anyway (BLKDEVXX.PO).
    [ff.c, ffconf.h]
2023-04-20 MMC driver updates to fix Wiznet compatibility. The Eth driver uses a different SPI clock rate when speaking with the Wiznet module, so clock rate needs to be restored at beginning of every MMC opera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
    [mmc_avr.h, mmc_avr_spi.c]
2023-04-21 Added FTP server to Arduino. Apple II access is suspended while any FTP client is connected. FTP server is shut down when Apple II takes control of the Eth port (IP65 lib).
2023-04-22 Proper fix for MMC vs WIZnet SPI issues. Now takes proper care when the SPI bus is still blocked, before accessing the WIZnet SPI device.
    [Apple2Arduino.ino, config.h, mmc_avr.h, mmc_avr_spi.c, ttftp.ino]
2023-04-30 Added firmware update utility for the DAN][ controller (Arduino firmware). Also added hex file with the customized Arduino bootloader (see https://github.com/ThorstenBr/MiniCoreDAN2Controller on how 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
2023-05-04 Renamed "firmware" and "flash" to "eprom" to avoid confusion with the Arduino flash. Slightly restructured the utilities folder.
    [eeprom_update.asm, sram_update.asm]
2023-05-04 Corrected hex file with bootloader to use the custom instead of the default Arduino bootloader.
2023-05-05 Add alternate 3D Ethernet bracket. Minor fix to build order of Arduino vs boot programs.
    [Apple_IIe_EthernetMount.stl]
2023-05-08 Integrated FTP/IP configuration into the boot menu. The separate utility is now obsolete (still working but no longer required).
    [Apple2Arduino.ino, bootpg_ipcfg_v5.asm, bootpg_ipcfg_v5.h, config.h, ttftp.h, ttftp.ino]
2023-05-08 Revised arduino code to remove duplicated code using arrays for slot_state, slot_fileno rather than separate variables
2023-05-13 Fixed bug with alternating drive access. Accessing both drives in quick succession, while writing to one of the drives, could result in access errors. Before switching access between drives 1 and 2 w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
    [diskio_sdc.c]
2023-07-02 Minor tweaks & corrections Fixed build dependency with cpp files. Keep FTP/IP feature disabled on new cards (needs to be enabled manually). Enable builds without bootpg (to save space for debugging).
    [Apple2Arduino.h, Apple2Arduino.ino, bootpg_cursor_v4.h, bootpg_ipcfg_v5.h, config.h]
2023-07-02 Added a kludge to fix a warmstart issue with the custom bootloader (new custom bootloader + Arduino firmware). This fixes a deadlock when ProDOS accesses a disk immediately after a warmstart (after C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
    [Apple2Arduino.ino]
2023-07-04 New more flexible boot menu. Allow selecting boot drives from either SD card. Also requires new flexible Arduino firmware.
2023-07-04 Allow FTP to write slightly oversized files of 65536x512 bytes. ProDOS only support up to 65535 blocks (of 512 byte). However, some raw images "on the internet" actually still have 65536 blocks. So, 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
    [ttftp.ino]
2023-07-04 FTP: improved error messages Separately report "file too large" vs "I/O error", so it's easier to tell what the actual issue is (size of file exceeds storage container vs some I/O error in accessing 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
    [ttftp.ino]
2023-07-14 Blink LEDs when no SD cards are found. Provides useful feedback when building new cards: 1. First startup test of the Arduino without SD cards => SD1/2 blink three times 2. Plug SD in slot 1 => LEDs 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
2023-07-30 Newer PCB photo showing Dan's latest rev 1.1 PCB.
2023-08-05 Force console system language to English when building (otherwise the arduino-cli log with the code/data sizes is in German on my system)
2023-08-05 Removed obsolete config option. No longer had any effect. Option was replaced by the more flexible configuration menu.
    [config.h]
2023-08-09 Minor optimization: only check the naming scheme once. Do not repeat the test for the second SD slot, if a match was already found with the first SD slot.
2023-08-09 Bugfix for FAT support: Properly close the file handle before switching to another file on the same disk. This sometimes caused FAT files to be not properly opened (not being accessible).
    [dan2volumes.cpp]
2023-08-09 x44: First revision for the Atmega 644 (and 1284?)
    This is a straight derivative version with most small parts converted to
    SMT. Also all using footprints and references from JLPCB, so as of
    today, you can order a fully built card; it'll just be missing the
    Atmega, which is not in stock, but is easy to add...
    I still used the 'hand soldering' footprints from Kicad so it should be
    easy to modify and rework.
    Oh also, I simplified some things, re-layout the schemastic on an A3
    sheet, and replaced diodes with a LDO with good filtering, that should
    improve SD card compatibility.
    I removed some test headers, re-layouted all the connectors at the top,
    and moved the LEDs at the front.
    To amuse m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
    [Apple2Card-CuBottom.gbr, Apple2Card-CuTop.gbr, Apple2Card-EdgeCuts.gbr, Apple2Card-MaskBottom.gbr, Apple2Card-MaskTop.gbr, Apple2Card-NPTH.drl, Apple2Card-PTH.drl, Apple2Card-PasteBottom.gbr]
2023-08-09 x44: Updated the schematics .pdf
    'Printed' the new A3 version.
    Also added a Readme with a warning, as nothing has been tested yet.
    [Apple2Card.kicad_sch]
2023-08-09 644: Initial Compilation/port
    Found out how to install Mega644 arduino stuff (See Makefile comments),
    updated the Makefile to make it compatible to either 328 or 644 (or
    both). It still default to 328, use make X4=1 to build the 644 version.
    Also added a V=1 support to show the makefile progress when needed.
    Added some updated pindef.h, altho seems the code doesn't use it that
    much! At least the CD lines for the SD card are hard coded, so I'll have
    to comb the code to find anything that is 'different' enough to require
    fixing.
    I haven't updated the bootloader, as I can't find the source for the
    danII bootloader version, yet.
    # Conflicts: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
    [pindefs.h]
2023-08-09 Minor updates to PCB & schematics: - Realigned some components (LEDs etc). - Added some clearance to the slot connector (now allows production with "chamfered edges"). - Show component values on the 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
    [Apple2Card-B_Cu.gbr, Apple2Card-B_Mask.gbr, Apple2Card-B_Silkscreen.gbr, Apple2Card-Edge_Cuts.gbr, Apple2Card-F_Cu.gbr, Apple2Card-F_Mask.gbr, Apple2Card-F_Silkscreen.gbr, Apple2Card-NPTH.drl]
2023-08-25 Added custom boot menu support for Apple ///. The Apple /// boot menu is not integrated into the firmware, but can now be loaded from a file on an SD card instead. This avoids having to distribute di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
    [Apple2Arduino.ino]
2023-09-03 Added optional file for local environment setup. localsettings.mk can be used (locally) to set up a path for arduino-cli, or to configure the DANII controller's IP address and volume file for local t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
2023-09-03 Documentation updates Matched name of ATmega328 Gerber file and link in README. Adapted links in README to use relative paths. Updated PCB image. Incorporated Dan's comment concerning D7/R20: they ar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
    [Apple2Card.kicad_pcb, Apple2Card.kicad_sch]
2023-09-03 Fixed Makefile abort-on-error issues. "make build" no longer aborted with an error (caused by the "||" to print an error message for installation errors). Separated the installation check into a sepa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
2023-09-03 pindefs: Update names & numberings
    These constants were barely used, and were originaly based on arduino
    numbers....
    + Renamed them to bit/pin number instead (part from CS2 that gains a
    D_CS3).
    + Added the all important SLAVE_S pin for the 644.
    + Changed DISABLE_CS to not touch all 8 bits of PORTB
    + Converted all macros to use pin defines, instead of hard coded
    numbers.
    + Added some explanation as to why wer need multiple ACK_LOW and STB_LOW
    + Moved CS_ADD from the code to this header
2023-09-03 mmc: Use pin definitions instead of hard coded values
    * Removed <Arduino.h>, turns out it's not needed
    * Converted all macros to use names found in pindefs.h
    * Changed power_on to use the macros, AND make sure we don't nuke bits
    of PORTB we aren't suposed to touch
2023-09-03 ftp: Use D_CS3, not CS3
    Renamed that constant, make sure the D_ constant is used, this is the
    only place we use the arduino names
2023-09-03 main: Use constants instead of hard coded numbers
    Now use CSx instead of pin numbers
2023-09-03 main: 644: Make sure PORTB4 is configured!
    Make sure the SS pin is configured, otherwise SPI crashes during
    transfer
    [Apple2Arduino.ino]
2023-09-03 644: Updated v.1 schematic to add LCSC parts
    Also updated the readme.
    [Apple2Card.kicad_sch]
2023-09-08 Imported Arduino Ethernet Library. Preparation of replacing the default Arduino Ethernet library with a customized version. => Import of the original sources.
2023-09-08 Customized the Ethernet library. Added feature switches to disable DNS+DHCP and legacy support for W5100/W5200 modules. This saves a ton of memory - freed up more than 4KB flash and >100bytes of RAM.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
    [Dhcp.cpp, Dns.cpp, Dns.h, Ethernet.cpp, Ethernet.h, EthernetClient.cpp, EthernetUdp.cpp, config.h]
2023-09-11 Trigger a PHY reset when initializing the Ethernet support. Since we don't have the RESET line connected to the Wiznet, triggering a full PHY reset is a good idea. It fixes occasional hickups with th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
    [w5100.cpp]
2023-09-13 fwupdate: Compile a 644 and a 328 fwupdate! Revised patch by Michel Pollet <buserror@gmail.com> for ATMEGA644P support. - Adapted to switch between ATMEGA328 and ATMEGA644 page size. - Consider actua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
2023-09-13 Adapted hex2bin to use the given image size to cut off extra data. We use this to cut off the bootloader for ATmega328p. For Atmega644p the image size is cut to a fixed (currently supported) maximum 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
    [hex2bin.py]
2023-09-13 Added hardware type check to fw update utility. Show board type (ATMEGA328P vs 644P). Prevent update when type mismatches. Add firmware updater for ATmega328P and 644P (if present).
    [dan2stk500.asm]
2023-09-14 Simplified ATMEGA variant building. Use "make ATMEGA=328P" or "make ATMEGA=644P" to select the board variant. Also supports "make 328P" or "make 644P" or "make all" on the top level.
2023-09-20 Added ethernet bracket for Apple ///.
    [AppleIII_Wiznet_Slot_Bracket.stl]
2023-09-23 Added DOS3.3 based firmware updater, to be used with Apple ///. The ProDOS-based firmware update utility doesn't work on Apple /// (no ProDOS support), so we build a DOS 3.3 based variant instead. Th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
    [dan2stk500.asm, fwupdate.asm]
2023-09-23 Minor: fix assembler warning about unused local label.
    [dan2stk500.asm]
2023-09-25 Improved 3D enclosure for Apple IIe Ethernet bracket. Fits into the Apple IIe's DB19 opening next to slot 7.
    [Apple_IIe_EthernetMount.stl, Apple_IIe_EthernetMount_DB19.stl]
2023-10-03 Minor tweak to silkscreen: indicator where fixed jumpers should be soldered.
    [Apple2Card.kicad_pcb]
2023-10-06 Added ld65 configuration file for APPLE /// SOS.
    [apple3sos.cfg]
2023-10-07 Uff. Fixed the mysterious issue with Apple III resets. Adds extra synchronisation to workaround an Apple III hardware bug, where the NMI was already executed while IO was still reset and unable to re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
    [dan2stk500.asm]
2023-10-19 Fixed issue with menu when aborting the configuration. When aborting with ESCAPE, do not highlight volumes when these previously selected volumes are located on a different page.
    [bootpg_128vols_v7.asm]
2023-10-19 Also extended RAW disk support to 128 volumes per SD card. Properly considers actual SD card size to calculate maximum number of volumes (otherwise SD cards enter an error state when accessing blocks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
    [bootpg_128vols_v7.asm, dan2volumes.cpp]
2023-10-25 Provide better error message for active FTP connection attempts. Handle and reply to the "PORT" command, which initiates an active FTP session (which we do not support). Some minor clean-up.
    [config.h, ttftp.ino]
2023-11-05 Corrected source documentation. Information on next free EEPROM cell was incorrect.
    [Apple2Arduino.ino]
2023-11-25 Fixed sporadic issue with menu showing mouse text instead of a flashing selection bar after a warm start. The soft switches in the Apple IIe IOU only receive a hardware reset at power-on. Run-time re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
    [bootpg_128vols_v7.asm, bootpg_128vols_v7.h, bootpg_cursor_v4.h, bootpg_flex_v6.h, bootpg_ipcfg_v5.h]
2023-11-29 Added tiny bootpg stub for Apple ///. The Apple /// bootpg needs to be installed on the SD card, to save flash memory - and since most users with an Apple II don't need it. However, if the bootpg for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
    [APPLEIII_bootpg_stub.asm, APPLEIII_bootpg_stub.h, APPLEIII_startup.asm, Apple2Arduino.ino, bootpg_128vols_v7.h, bootpg_cursor_v4.h, bootpg_flex_v6.h, bootpg_ipcfg_v5.h]
2023-12-05 Updated PCB photo.
2024-01-17 Added interactive BOM.
    [Apple2Card.kicad_pcb]
2025-02-25 Initial Upload
    Initial Upload
    [Apple2Card-CuBottom.gbr, Apple2Card-CuTop.gbr, Apple2Card-EdgeCuts.gbr, Apple2Card-MaskBottom.gbr, Apple2Card-MaskTop.gbr, Apple2Card-NPTH.drl, Apple2Card-PTH.drl, Apple2Card-PasteBottom.gbr]
2025-04-05 Update to new schematics.
    [Apple2CardCR-B_Cu.gbl, Apple2CardCR-B_Mask.gbs, Apple2CardCR-B_Paste.gbp, Apple2CardCR-B_Silkscreen.gbo, Apple2CardCR-Edge_Cuts.gm1, Apple2CardCR-F_Cu.gtl, Apple2CardCR-F_Mask.gts, Apple2CardCR-F_Paste.gtp]
2025-04-05 Added remixed mount for IIe/IIgs
    [Apple IIe Ethernet Bracket Remix -M3 -Internal Bracket.stl, Apple IIe Ethernet Bracket Remix -M3.stl]
