dabonetn/Apple2Card-Dan-CR-Board-/(notices)

Notices in the files:
OriginalFiles/Apple2Arduino/EthernetLib/EthernetUdp.cpp:
MIT License:
Copyright (c) 2008 Bjoern Hartmann
